Dy390/Documentacion/README.md

# Documntacion del Proyecto 🛠️

_📋 El proyecto consta de distinta informacion documentada en diferentes archivos y formatos._

## Despliegue de informacion 📦

* [🖇️ Circuitos](https://github.com/Dy390/Documentacion/tree/master/Circuitos) - Circuitos esquematicos del proyecto.
* [📄 Especificaciones Tecnicas](https://github.com/Dy390/Documentacion/tree/master/Especif_Tecnicas) - ET del proyecto.
* [📖 Manuales](https://github.com/Dy390/Documentacion/tree/master/Manual) - Manual General, Manual Tecnico, etc.
* [📌 Notas](https://github.com/Dy390/Documentacion/tree/master/Notas) - Notas relacionadas al proyecto.
* [🔧 Herramientas](https://github.com/Dy390/Documentacion/tree/master/Herramientas) - Herramientas del proyecto
* [📄 Protocolos](https://github.com/Dy390/Documentacion/tree/master/Protocolos) - Protocolos

## Autores ✒️

_Quienes desarrollamos aportamos y ayudamos a levantar el proyecto desde sus inicios_

* **Diego Andrés Riquelme** 

## Licencia 📄

Este proyecto está bajo la Licencia 

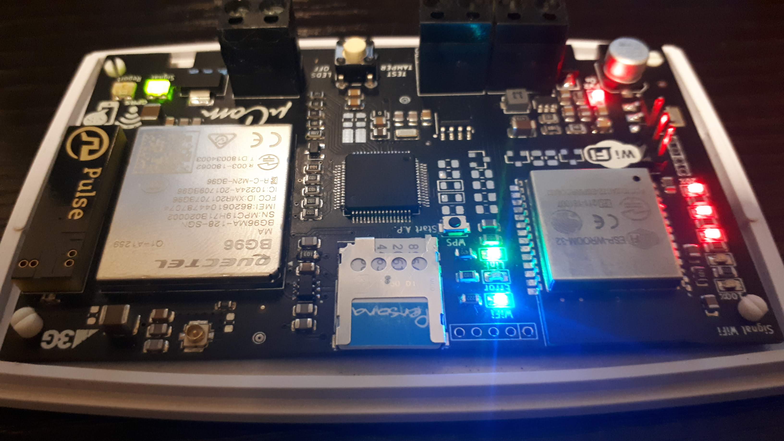
[picture p1: 20200423_143925.jpg]

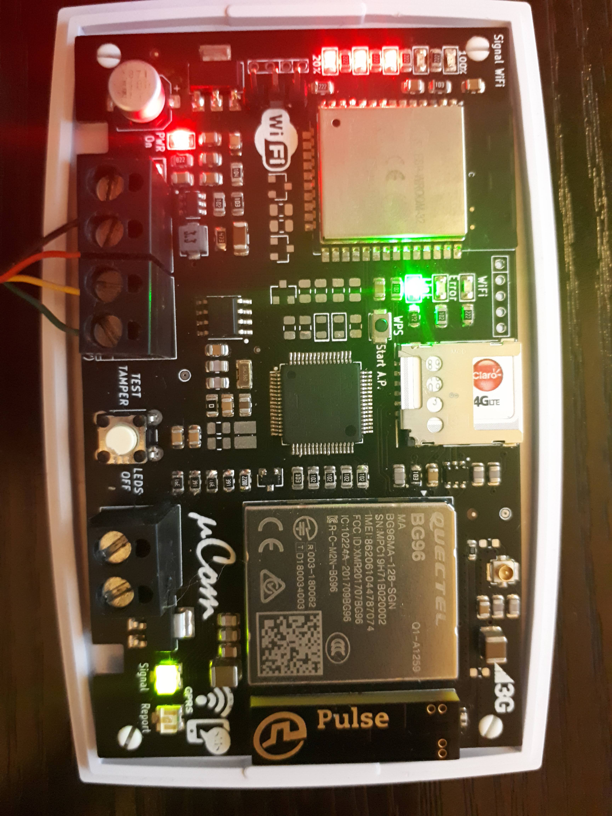
[picture p2: 20200424_222755.jpg]
