Dy390/Documentacion/Especif_Tecnicas/ET_070419_uCOM IP-WIFI_GSM-EGPRS-4G_LTE.pdf

Especificación Técnica: ET-070419 µCom: Comunicador por Bus de Datos

SIIA 04/2019
Rev.: A
1

## ESTADOS DE LED’s DISPOSITIVO

## 1. LED’s DE NIVEL DE SEÑAL WIFI

El equipo “µCom ” indica el nivel dispuestos en placa de la siguiente manera:

LED1 = 20% o menos de señal WiFi recibida).

LED2 = 40% o menos de señal Wi
poderse mejorar).

LED3 = 60% o menos de señal WiFi obtenida (es aceptable y no debería tener inconvenientes)

LED4 = 80% o menos de señal WiFi obtenida (muy aceptable).

LED5 = 100% o menos de señal WiFi obtenida (ideal).

## 2. LED WIFI – WPS - AP (Acces Point)

La indicación de este LED hace referencia al modo en el que trabaja el modulo de comunicación inalámbrica, indicando esto de la sigu

LED WiFi/WPS/AP (Azul)

Encendido fijo = | Indica modo AP
Destellando lento = | Indica WiFi encendido y
Destellando rápido = Indica en modo WiFi e

## 3. LED ERROR / NO-NET

Este LED indica el estado de conexión a la red

LED ERROR / No-Net (Rojo)

Destellando = | buscando conexiones WiFi
Encendido fijo = | No logro conexión con ninguna red WiFi
Apagado = | conectado correctamente a la red WiFi

CONFIDENCIAL

## Y DESCRIPCION DE SWITCHES SIIA µCom) GPRS-GSM/IP-WiFi

de señal WiFi captada en el lugar mediante la indicación

obtenida (se recomienda reubicar dispositivo

Fi obtenida (si se mantiene sin fluctuaciones es aceptable de no

o menos de señal WiFi obtenida (es aceptable y no debería tener inconvenientes)

hace referencia al modo en el que trabaja el modulo de comunicación iente manera:

encendido y WiFi apagado.
AP apagado.
l WPS (aprendiendo red)

conexión a la red WIFI de la siguiente manera:

No logro conexión con ninguna red WiFi conectado correctamente a la red WiFi

## WiFi

de 5 LED’s

para mejorar la señal

2

## 4. LED LINK DE RED WIFI

La indicación de este LED Link, hace referencia a la conexión IP/Dinamic DNS, perteneciente al servidor de recepción de los paquetes de datos por parte del centro de monitoreo.

LED LINK (Amarillo)

Encendido fijo = | Enlazado correctamente
Apagado = | No hay enlace con el Servidor de monitoreo (se recomienda revisar parámetros)
Un destello corto = | El led Link realiza un parpadeo corto cada vez que recibe un ACK d
principal.
Dos destellos cortos = El led Link realiza dos
2 o secundario.
Destellando = | Reservado (aplicación futura)

## 5. LED’S DE LA RED GSM/GPRS

La conexión GSM/GPRS/LTE-M está indicada con dos L
pertinentes al funcionamiento del modulo de comunicación celular vía la red GSM/GPRS por tecnología 2G/3G Y LTE-M por tecnología 4G
Las indicaciones de estos LED’s son las siguientes:

LED DUALES BICOLOR (Verde/Rojo)

EN LA ECUENCIA DE ARRANQUE

LED1 = Enciende por 7 seg
Se mantiene encendido verde fijo al iniciar el modulo GSM en estado OK. LED2 = Rojo fijo indica inicio/reinicio del modulo GSM. Rojo intermitente

SECUENCIA MODULO INICIADO NORMAL

LED1 = Fijo en verde indicando funcionamiento OK del modulo Destellos (de 1 a 5) rojo sobre verde fijo cada 10 seg
LED2 = Fijo en verde indica estado de
Tres pulsos Rojo rápido
Pulsos en color Ámbar después de los pulsos de transmisión de paquetes respuesta ACK a los paquetes

SECUENCIA MODULO CON PROBLEMA

LED1 = | Destellos rápidos
LED2 = | Pulsos Rojo sobre apagado indica Modulo intentando iniciar/buscando

Link, hace referencia a la conexión IP/Dinamic DNS, perteneciente al servidor

vía WiFi a IP/DNS del servidor de monitore No hay enlace con el Servidor de monitoreo (se recomienda revisar parámetros) El led Link realiza un parpadeo corto cada vez que recibe un ACK d

parpadeos cortos cada vez que recibe un ACK d

Reservado (aplicación futura)

## /LTE-M

está indicada con dos LED’s bicolor en placa para realizar las

’s son las siguientes:

. con destellos rápidos rojo en proceso de inicio del modulo e mantiene encendido verde fijo al iniciar el modulo GSM en estado OK.

rápido indica búsqueda de SIM/SIM no detectada.

Fijo en verde indicando funcionamiento OK del modulo
Destellos (de 1 a 5) rojo sobre verde fijo cada 10 seg. indicando nivel de señal. conexión general del Modulo en la red OK rápido indican trasmisión de paquetes de datos en color Ámbar después de los pulsos de transmisión de paquetes a los paquetes recibidos por el servidor.

en rojo sobre apagado indicando Modulo no alimentado Pulsos Rojo sobre apagado indica Modulo intentando iniciar/buscando

o

el Servidor 1 o

el Servidor

indicaciones

indican

SIM, etc.

3

## 6. TOUCH SWITCHES EN PLACA

En la placa del µCom IP-WiFi / GSM
modos del equipo, los mismos están indicados y responden a las siguientes operaciones:

MICRO TOUCH SWITCH MODO WIFI/

Este pulsador obedece al ser presionado por 3 segundos,
para operar la programación
utilización de la aplicación par

TOUCH SWITCH MODO WPS

Al pulsarlo por menos de 3 segundos de los datos de la red WiFi del lugar SSID y PASSWORD de la red WiFi.

TAMPER SWITCH MODO DE PLACA

Este switch tiene prevista la acción principal de reporta ante su apertura la señal correspondiente al evento de anti-desarme y su restauración al cerrarse debidamente el equipo. Pero además cumple la función de poder reportar eventos de
segundo para hacer envíos de prueba al centro de monitoreo. Con la llegada de este reporte, enviara el nivel de señal WiFi que posee el equipo entre otros datos del sistema.
Por último este mismo switch es el enc
cuando el dispositivo es cerrado definitivamente al finalizar la instalación y su ubicación correcta, esto tiene el objeto de bajar el consumo del equipo al máximo evitando
LED’s que ya fueron chequeadas y no son necesarias luego de finalizado el trabajo de instalación.

-GPRS existen tres Touch switches para operación de distintos

AP/WPS

al cambio de modo W
de parámetros del equipo de de forma sencilla y rápid a sistemas operativos Android.

realiza la acción de ingreso a WPS para
, sin tener la necesidad de configurar manualmente

desarme y su restauración al cerrarse debidamente el equipo. Pero además cumple supervisión presionando el mismo por menos de un

i que posee el equipo entre otros datos del sistema. argado de desactivar todos los LED’s

encender
fueron chequeadas y no son necesarias luego de finalizado el trabajo de instalación.

iFi a conexión AP
a mediante la

la autoconfiguración
manualmente los datos de

nando el mismo por menos de un

’s que no son necesarios

encender indicaciones en
