Dy390/Documentacion/Especif_Tecnicas/ET_140220_uCOM_ConectoresPCB.pdf

Especificación Técnica: ET-140220
µCom: Conectores de PCB (Programación – Configuración

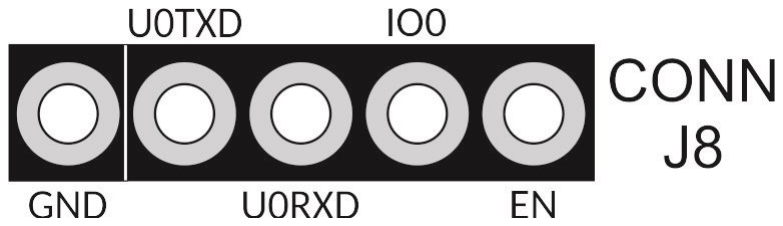
[picture p5: figure]
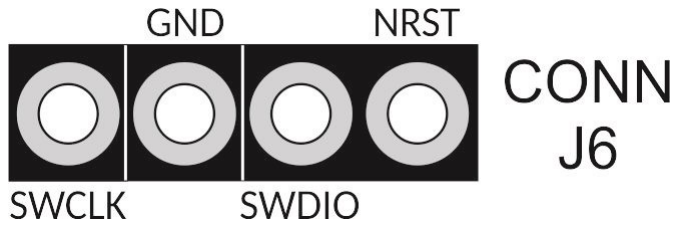
[picture p6: figure]

SIIA 02/2020
Rev.: A
1

# CONECTORES DEL PCB

### 1. CONECTOR DE PROGRAMACION ESP

El conector de programación del ESP-WROOM Los pines utilizados son los siguientes:

1 . GND | => NEGRO
2 . TXD (USART0) | => VERDE
3 . RXD (USART0) | => AZUL
4 . IO0 | => BLANCO
5 . EN | => ROJO

### 2. CONECTOR DE PROGRAMACION SWD

El conector de programación del microcontrolador ST32G070RB es un conector de 4 pines vertical del tipo 1x04 paso = 2mm
Se utiliza SWD del ST-Link-V2 (Discovery
Los pines utilizados son los siguientes:
1 . SWCLK (CLOCK) | => AMARILLO
2 . GND | => NEGRO
3 . SWDIO (DATA) | => VERDE
4 . NRST (RESET) | => NARANJA

### 3. CONCTOR DE CONFIGURACION Y DEBUG SERIAL

El conector de programación de programación
Se utiliza en configuración estándar serial RS232 TX
Los pines utilizados son los siguientes:
1 . GND | => NEGRO
2 . TX (Trans. Data) | => AMARILLO
3 . RX (Res. Data) | => VERDE

Configuración – Debug)

CONFIDENCIAL

# CONECTORES DEL PCB µCom

### -WROOM-32

WROOM-32 es un conector del tipo de 5 pines verticales del tipo

### SWD DEL STM32G070RB

-Nucleo64-clon chino USB)

serial es un conector de 3 pines vertical del tipo -RX

1x05 paso = 2mm

1x03 paso = 2.54mm
