Dy390/Documentacion/Especif_Tecnicas/ET_Terminologia_Comandos_SMS.pdf

Especificación Técnica: ET-060419 µCom: Terminología de comandos de p

SIIA 04/2019
Rev.: | A
Pag. | 1

La programación se realiza por completo en forma remota por la App bien por SMS.

Introducción a la programación por

El procedimiento de programación por SMS de un comunicador
diseñado para que sea sencillo e intuitivo, de manera que sea posible programarlo desde cualquier teléfono celular. Simplemente
es necesario seguir una serie de reglas sencillas y conocer los comandos para la configuración de los diferentes parámetros del equipo.
guardada como plantilla en el teléfono celular, en caso que se quiera utilizar alguna función especial del equipo podría ser necesario consultar el manual.

Para la programación del equipo e
comunicador, también llamad

La clave de programación o P

La programación se puede realizar desde cualquier teléfono celular vía SMS.

Se puede programar el comunicador enviando SMS
al número de la SIM del comunicador, los mensajes deben comenzar con el siguiente encabezado y continuar con los distintos comandos o parámetros separados entre comas.

Encabezado: MCLTE*1234,

Donde MCLTE es el encabezado que
la PROGKEY del comunicador.

Los SMS no deben superar los 140 caracteres, en caso de mayor longitud, de enviar varios SMS, pero todos con el mismo encabezado. No se exige ningún orden en los comandos.
Los comandos y parámetros con contenido numérico deben tener la cantidad de dígitos especificada completando con ceros a la izquierda cuando sea necesario. Lo dicho no aplica para APNs, users, passwords, IPs, PORTs, y SMS.

Ejemplo de SMS a enviar desde cualquier teléfono celular o modem SMS al SIM
del comunicador:

MCLTE*1234,PROGKEY=4321,

Este comando de programación indica al comunicador, cuyo código de instalador es 1234, que cambie la PROGKEY a 4321
Como respuesta a cualquier comando o programación por SMS, el comunicador responderá con los SMS necesarios con toda su programación al celular o módem de
el SMS, lo que permite asegurase que la programación fue recibida y verificar si impactó en el comunicador como se deseaba.

REPORTES SMS RESIDENCIAL

MicroCom permite el envío de reportes
utilizando el servicio de SMS de la compañía telefónica.
Si el formato “SMS Residencial
el usuario podrá recibir reportes de eventos en sus teléfonos. Los eventos importantes transmitidos
Alarmas, Armado/Desarmado, Fallos de alimentación, entre otros.

419
rogramación SMS

## PROGRAMACIÓN SMS

Config del instalador o

SMS

MicroCom
para que sea sencillo e intuitivo, de manera que sea posible programarlo desde cualquier

En general la configuración básica es muy simple y se puede tener

s necesario conocer la clave de programación
a programming key en adelante PROGKEY

ROGKEY de fábrica es 1234.

’s desde un teléfono celular o modem

siempre debe estar presente al comienzo del mensaje y

smo encabezado. No se exige ningún orden en los comandos.

ords, IPs, PORTs, y SMS.

con toda su programación al celular o módem desde donde recibió

AUTOMATICOS

automáticos a los teléfonos celulares configurados

” está habilitado en la programación del equipo MicroCom,

serán:

del instalador o

-WiFi/4GLTE está

del

1234 es

donde recibió

nfigurados

Pag. 2

COMANDOS REMOTOS DEL USUARIO

Otra facilidad de MicroCom es la de poder enviar remotamente comandos al sistema de alarma en forma de mensaje SMS si esta se encuentra habilitada en la
Si por razones de seguridad quiere limitar el uso de comandos remotos SMS, solamente a teléfonos de conocimiento del usuario, entonces estos deben estar previamente configurados en MicroCom para ser contrastados con los teléfonos
contrario MicroCom responderá al mismo teléfono que envió el mensaje SMS, siempre y cuando respete el formato de comunicación obligatorio.

Formatos de Comandos: [s][clave][
Donde:
[s] = | es un espacio, un punto, un asterisco (*) o un numeral (#)
[clave] = | es la clave de usuario de partición
[s] = | es un espacio
[comando] = | es el comando a ejecutar según tabla
[s] = | es un espacio solo si hay nº zona como parámetro Ej. (z01)
[parámetro] = Numero de Zona de uno o dos caracteres
| Salida [OUT]

* Comandos en letra minúscula

Ej. para ejecutar la acción SMS de Armar y Desarmar
ARMAR: | [ 1234 armar]
DESARARMAR: [ 1234 desarmar
* (Tener en cuenta el espacio inicial)
** (1234 = clave del usuario para la Partición

Ej. para ejecutar la acción SMS de Anular y Restaurar zona 5 enviar:
ANULAR ZONA: | [ 1234 anular z05
RESTAURAR ZONA: | [ 1234 restaurar z05
* (Tener en cuenta el espacio inicial)
** (1234 = clave del usuario para la Partición
Ej. para ejecutar la activar la Salida [OUT] del equipo
ACTIVAR SALIDA: | [ activar salida
DESACTIVAR SALIDA: | [ desactivar salida
* (Tener en cuenta el espacio inicial)
** (este comando no necesita clave del usuario

El equipo responderá a estos comandos

SISTEMA ARMADO
SISTEMA DESARMADO
ZONA 05 ANULADA
ZONA 05 RESTAURADA

:

programación de MicroCom.

que envían el mensaje SMS

s][comando][s][parámetro]

espacio, un punto, un asterisco (*) o un numeral (#)

e idioma.
es un espacio solo si hay nº zona como parámetro Ej. (z01)
Numero de Zona de uno o dos caracteres precedidos de espacio, o
| ESPAÑOL * | PORTUGUEZ * | INGLES *
ARMAR SISTEMA (CERRAR) | armar | armar | arm
DESARMAR SISTEMA (ABRIR) | desarmar | desarmar | disarm
ANULAR ZONA | anular | cancelar | bypass
DESANULAR ZONA | restaurar | restaurar | restore
ACTIVAR SALIDA | activar salida | ativar saída | output on
DESACTIVAR SALIDA | desactivar salida | desativar saída | output off
ACTIVAR SIRENA | activar sirena | ativar sirene | bell on
DESACTIVAR SIRENA | desactivar sirena | desativar sirene | bell off
CONSULTA ESTADO | estado | estado | status

de Armar y Desarmar enviar:

]

)

1234 anular z05 (puede enviarse 05, o también 5)] 1234 restaurar z05 (puede enviarse 05, o también 5)]

)
alida [OUT] del equipo:
]
desactivar salida]

)

con los siguientes textos indicando el estado del panel

. De lo

Activar

Pag. 3
