Dy390/Documentacion/Especif_Tecnicas/ET_290319_uCOM_FORMATO DE COMUNICACION DE PAQUETES.pdf

Especificación Técnica: ET-290319 µCom: Comunicador por Bus de Datos

SIIA 03/2019
Rev.: A
1

CONFIDENCIAL

## ESPECIFICACION DEL FORMATO DE MENSAJES USADOS EN EL DISPOSITIVO IP-WiFi/

## 1. Conceptos Iniciales

En este documento se detalla el reporte de eventos hacia la equipo usando el protocolo de comunicación ContactID Llamaremos “µCom ” (micro_communicator) interconexión a un Panel de alarmas en forma directa
Cada mensaje enviado por el dispositivo
proveniente desde el sistema receptor en la
Si el µCom no recibe un ACK dentro de un tiempo establecido, luego de realizar todas las programadas, entonces reintentará el envío por SMS
está habilitado para usar estos servicio

## 2. Comandos, Reportes y Seguridad

Definiremos como “Comando” a aquellos mensajes de datos enviados al
remoto con fines de consulta, configuración, o control remoto. Todo comando espera dispositivo.
Los Comandos no se detallan en este documento
De la misma forma, definiremos como “Reporte” a los mensajes enviados por el destinatario, conteniendo reportes de alarmas, problemas, test, etc. El
sean “reconocidos” (o respondidos) por su receptor.
En el caso que se envíe un mensaje por SMS
dos caracteres ASCII, representando el valor hexadecimal del byte. De esta manera se garanti
los caracteres sean aceptados por los diferentes “data schemes”. Al final, la estructura del mensaje será similar a la usada para GPRS.
En SMS se espera que el mensaje de respuesta o ACK, se reciba por el mismo medio.
Cuando se transmita por GPRS, se usará UDP para comunicar con la C
En ambos casos el mensaje del evento puede estar encriptado o no, dependiendo de la configuración del µCom.
En el caso que se encripte el mensaje, la totalidad del mismo será

## 3. Reportes con Protocolo

Este protocolo debe parecerse al implementado por otros fabricantes de productos IP. El protocolo se transmite tanto por GPRS / IP como por SMS sin encriptación.
Para la detección de errores, se utiliza
Se transmite siempre, usando UDP.
A continuación, un ejemplo de los reportes que se generan en el dispositivo envían en el reporte son con estructura Contact ID.
Los diferentes campos de la información e

# SIIA microCom (µCom)

## GSM-UMTS-LTE-M (2G-3G-4G)

detalla el reporte de eventos hacia la Centro Monitoreo de comunicación ContactID.
al Comunicador GPRS- GSM/IP
a través de su bus de datos. µCom, deberá ser validado por una respuesta de aceptación o ACK CMA.
no recibe un ACK dentro de un tiempo establecido, luego de realizar todas las (a la CMA) y/o vía Email o WhatsApp s.

µCom

en este documento (ver ET. Comandos).

µCom espera que todos los Repor

(a la CMA), cada byte será codificado para su transmisión, como

GPRS, se usará UDP para comunicar con la CMA.

encriptado.

## Contact ID

al implementado por otros fabricantes de productos IP.

el cksum del Contact ID.

stán separados por comas (,).

)

Alarmas (CMA) desde el

IP-WiFi, diseñado para su

repeticiones
(al Usuario) solo si

desde un sistema receptor
rá una respuesta del

µCom hacia su receptor o
espera que todos los Reportes

za que todos

µCom. Los eventos que se

2

### $D,acct,seq,timestamp,CIDdata,RSSI,frec,vers,id,$C

Donde:

$D | Es un header de 2 caracteres: ASCII 36 (hex. 24) seguido del ASCII 68 (hex. 44).
acct | Este campo es para identificar al dispositivo IP. Son siempre los 4 dígitos del Número de
Cuenta correspondiente al
seq | A cada mensaje se le aplica un número de secuencia o número de mensaje. El sistema de
recepción responderá con un mensaje de ACK con el mismo número de mensaje al cual se está reconociendo. El rango es de 01 a 99 y son siempre 2 cifras.
DateTime Indica en qué fecha y hora
formato es: DD/MM/YYYY
CIDdata La totalidad de los datos son caracteres ASCII y corresponden a una estructura de Contact ID con 16 cifras.
RSSI | Son dos caracteres indicando el nivel de señal recibida. Los valores transmitidos son los
que muestra el modulo
señal). Solo válido para dispositivos GPRS.
frec | Este campo especifi
Vers | Este campo especifica el número de versión del hardware y del Firmware
caracteres.
Id | Son 7 dígitos correspondientes al ESN que coincide con el final del IMEI en disposit
GPRS.
$C | Este es el finalizador

Ejemplo:
$D,8888,01,01/01/2000-00:0
4. Reporte Periódico de Supervisión (Prot.

Cuando se opera en GPRS, se puede generar un reporte periódico de supervisión, que solo se envíe por este medio. Es decir, si no se recibe ACK de este mensaje no se enviará por SMS.
La estructura del mensaje de supervisión es la misma que en el ejemplo an
denominado CIDdata se llena con 16 ceros.
Así, el ejemplo anterior queda:
$D,8888,01,01/01/2000-00:00
$D | Comienzo del paquete de datos
8888 ID del dispositivo (

### 01 Numero de paquete (01 a 99)

01/01/2000 | Fecha DD/MM/AAAA
00:00 | Hora y Minutos
0000000000000000 | Protocolo Contad

### 18 Nivel de señal

2 Supervisa cada 2 minutos.
5_6.7 | 5 Es la versión de hardware de placa y 6.7 versión de firmware

Es un header de 2 caracteres: ASCII 36 (hex. 24) seguido del ASCII 68 (hex. 44).
Este campo es para identificar al dispositivo IP. Son siempre los 4 dígitos del Número de µCom (ID del panel de alarma). A cada mensaje se le aplica un número de secuencia o número de mensaje. El sistema de recepción responderá con un mensaje de ACK con el mismo número de mensaje al cual se está reconociendo. El rango es de 01 a 99 y son siempre 2 cifras.
fecha y hora el mensaje fue encolado para su transmisión a la -HH:MM y son siempre 16 cifras.
La totalidad de los datos son caracteres ASCII y corresponden a una estructura de Contact

Son dos caracteres indicando el nivel de señal recibida. Los valores transmitidos son los de GPRS con el comando AT+CSQ y van de 00 a 32 (32 = 100% de

ca la frecuencia de los reportes de supervisión de GPRS en minutos. Este campo especifica el número de versión del hardware y del Firmware

Son 7 dígitos correspondientes al ESN que coincide con el final del IMEI en disposit

dor del paquete. Son dos caracteres.

0, 0501183145010001,18,2,1_1.1,12

## CID)

,0000000000000000, 18,2,1_1.1,1234567,$C

Comienzo del paquete de datos Número de cuenta )
Numero de paquete (01 a 99)

-ID Si es todo 0 es un evento de supervisión
(es un número de 0 a 32 donde 32 es el 100 % de señal GSM

### 5 Es la versión de hardware de placa y 6.7 versión de firmware

CMA El

. Son cinco

ivos

34567,$C

terior, pero el campo

)

3

1234567 IMEI (últimas 7 cifras)
$C | Finalizador del

## 5. Acknowledges (Prot. CID

Cuando la CMA, recibe un evento desde el Ejemplo de respuesta de ACK:

### $D,8888,TI=01/01/2000-00:0

Esta es una respuesta de ACK para el ejemplo anterior, donde:
$D | Comienzo del paquete de datos
8888 ID del dispositivo
01/01/2012 | Fecha DD/MM/AAAA
00 :07:00 | Hora, Minutos y Segundos
ACK=01 | Número de paquete (01 a 99) que se
$C | Finalizador del paquete

paquete.

)

µCom, debe responder con un mensaje de reconocimiento.

### 0:00,ACK=01,$C

(Número de cuenta)

está reconociendo
paquete
