Dy390/Documentacion/Protocolos/POSITRON/PROTOCOLO DE COMUNICACIÓN DE LA RED HOME.pdf

## Protocolo de comunicación de la red HOME

## INTRODUCCION

Este documento describe el protocolo de comunicación de la red HOME, que se utiliza para establecer una red de comunicación para productos de la línea doméstica (estaciones de alarmas centrales, teclados, etc.).

## MENSAGE FORMATO GENERAL

El formato general del mensaje se presenta en la Figura 1. Esta figura muestra todos los campos del mensaje, incluso los opcionales. El significado de los campos se presenta en la tabla 1 y se explica con más detalle en los siguientes temas.

Figura 1 - Formato general del mensaje de protocolo HOME

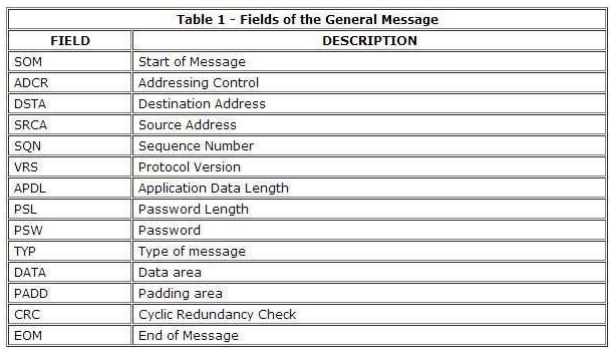
[picture p33: figure]

Table 1 - Fields of the General Message

## PROTOCOLO DE COMUNICACIÓN DE LA RED HOME -CAPA FÍSICA

La capa física utilizada en el protocolo HOME es RS485. Baud Rate: 57600 8bits / 1 stop bit No parity

## PROTOCOLO DE COMUNICACIÓN DE LA RED HOME – CAPA DE ENLACE DE DATOS

La capa de enlace de datos es responsable de generar o procesar el mecanismo de validación de mensajes (para la detección o recuperación de errores) y para la encapsulación de cuadros. Por lo tanto, esta capa agrega o procesa los campos de validación y encapsulación del mensaje, como se muestra en la figura 2.

CRC

Figure 2 - Parte del mensaje en la capa de enlace de datos

El CRC utilizado en este protocolo es una versión de 16 bits del CCITT, con el siguiente polinomio:

Marcando caracteres

Figura 3 - CRC polinomio

Los caracteres de marcado son caracteres especiales que se utilizan para marcar el inicio y el final del mensaje. Además, como estos caracteres pueden aparecer normalmente dentro del mensaje básico, existe un mecanismo para detectar y evitar este problema. Este mecanismo es la secuencia de escape y utiliza un carácter especial, el carácter de escape y un operador de escape, para evitar la incidencia de caracteres de marcado dentro del mensaje.

Los caracteres marcados y el operador de escape son:

- Inicio del mensaje (SOM): 0x28
- Fin del mensaje (EOM): 0x29
- Personaje de escape (ECH): 0x27
- Operador de escape (EOP): 0x40

El mecanismo de escape funciona de la siguiente manera: si, dentro del mensaje básico, hay un carácter equivalente a un carácter de marca, se inserta un carácter de escape (ECH) antes de que este carácter sufra una operación XOR con el operador de escape (EOP). ).

En la transmisión, los caracteres de marcado se agregan al mensaje después de que se compone el mensaje básico. En la recepción, los caracteres de marcado deben excluirse del mensaje antes de interpretar el mensaje básico.

## PROTOCOLO DE COMUNICACIÓN DE LA RED HOME -CAPA DE RED

La capa de red es responsable de controlar el mecanismo de direccionamiento del protocolo. Esta capa agrega o procesa los campos de dirección del mensaje, como se muestra en la figura 4.

Figura 4 - Parte del mensaje en la capa de red
ADCR - Control de direccionamiento

Este es un campo de bits con 1 byte de longitud, utilizado para controlar el mecanismo de direccionamiento del protocolo. La función de cada bit se muestra en la tabla 2 a continuación:

Tabla 2 - Control de direccionamiento
DSTA - Dirección de destino

Este es un campo opcional y contiene la dirección de destino (dirección del dispositivo que debe recibir el mensaje). Este campo no existe en los mensajes de difusión (mensajes dirigidos a todos los dispositivos en el bus).

SRCA - Dirección de origen

Este es un campo opcional y contiene la dirección de origen (dirección del dispositivo que generó el mensaje). Para mensajes que no necesitan respuesta, este campo no existe.

SQN - Número de secuencia

El número de secuencia es un campo de 1 byte y se utiliza para identificar los mensajes originales y sus respuestas. El mensaje de respuesta debe contener el mismo número de secuencia del mensaje que lo originó.

Para los mensajes que necesitan respuesta, el dispositivo de origen debe esperar la respuesta por un tiempo de espera determinado. Si este tiempo de espera expira y la respuesta no se recibe, la fuente debe reenviar el mensaje con el mismo número de secuencia. Además, el dispositivo de origen debe intentar enviar el mensaje una cantidad determinada de veces (este parámetro se conoce como número de reintentos). Después de que este número expire, la fuente debe darse por vencida.

Direcciones

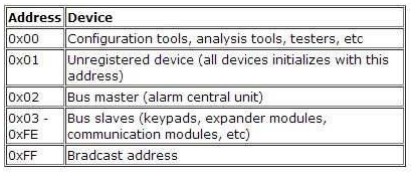
[picture p34: figure]

Tabla 3 – Direcciones

## PROTOCOLO DE COMUNICACIÓN DE LA RED HOME -CAPA DE PRESENTACIÓN

La capa de presentación es responsable de controlar el cifrado de la parte de la aplicación del mensaje (datos de la aplicación) y controlar la versión del protocolo. Esta capa agrega o procesa los campos de versión y de relleno del mensaje, como se muestra en la figura 5.

Figure 5 - Parte del mensaje en la capa de presentación

VRS - Versión

Este es un campo de bits con 1 byte de longitud. Los 4 bits menos significativos (bits 3 a 0) definen la versión del protocolo (la versión actual es 0). El bit más significativo (bit 7) define si el cifrado se aplica a los datos de la aplicación (si el valor del bit es 1, se aplica el cifrado). Los otros bits (6,5,4) no se utilizan ahora y son gratuitos para futuras necesidades (en este momento, se recomienda rellenarlos con 0).

APDL - Longitud de datos de aplicación

Este es un campo de 1 byte que contiene la longitud de los datos de la capa de aplicación. La capa de presentación necesita esta información para separar los datos de aplicación de los datos de relleno.

PADD - Área de relleno

Este campo contiene el área de relleno del mensaje, que es necesaria para algunos tipos de cifrado que restringen que los datos cifrados sean un múltiplo de cierta longitud (por ejemplo, un múltiplo de 4 bytes). Por lo tanto, si el cifrado tiene esta restricción y la longitud del mensaje no es un múltiplo de la longitud requerida, el mensaje debe completarse con bytes de relleno para alcanzar la longitud necesaria. Por ejemplo, si un mensaje tiene 13 bytes y necesita ser un múltiplo de 4 bytes, debe completarse con 3 bytes de relleno, para alcanzar una longitud de 16 bytes. El valor de los bytes de relleno debe elegirse de manera aleatoria y, preferiblemente, no debe ser igual. Si el mensaje no está cifrado, el área de relleno no es necesaria y no se incluye en el mensaje.

Cifrado

Si el cifrado está habilitado, se aplica a los datos de la aplicación y al área de relleno. En este momento, no se utiliza ningún cifrado (el bit 7 de VRS es 0).

## PROTOCOLO DE COMUNICACIÓN DE LA RED HOME -CAPA DE APLICACIÓN

La capa de aplicación es responsable de procesar o ensamblar la parte de datos del mensaje. Esta porción de datos está compuesta por los campos presentados en la figura 6.

Figura 6 - Parte del mensaje en la capa de aplicación

PSL - Longitud de la contraseña

Este campo informa la longitud de la contraseña, que es el siguiente campo del mensaje. Si no hay contraseña, PSL es cero.

PSW - Contraseña

Este es un campo opcional y contiene la contraseña del usuario que está accediendo al sistema. Hay algunos mensajes que no necesitan contraseña; en estos casos este campo no existe (PSL = 0). Consulte el Diccionario de datos para obtener una explicación del formato de las contraseñas.

Tipos de mensajes

El tipo de campo de mensaje se utiliza para identificar los mensajes. La siguiente tabla presenta el tipo de mensajes para el protocolo HOME y el significado del área de datos.

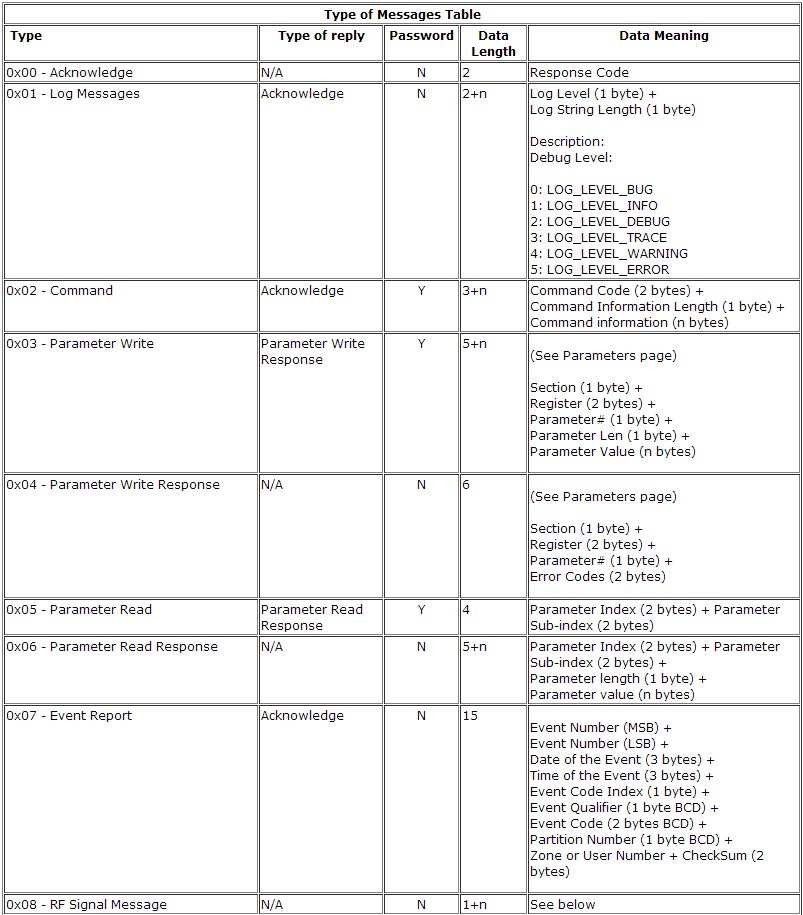
[picture p35: figure]

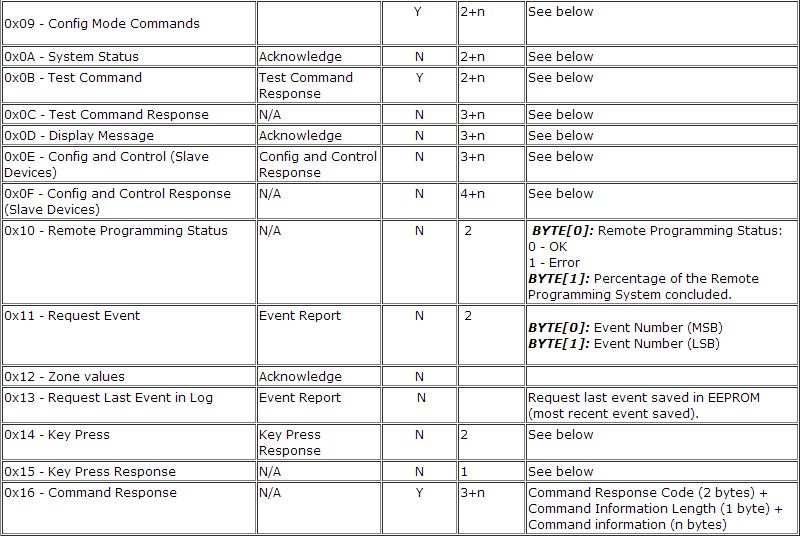
[picture p36: figure]

Tabla 4 – Tipo de Mensaje

Obs: solo las contraseñas de instalador y maestro (maestro de sistema y maestro de particiones) deben aceptarse en los mensajes que necesitan contraseña. Los mensajes que vienen con las contraseñas de los usuarios normales deben ser rechazados.

Formato de los datos

Ver Protocolo de comunicación de red HOME - Diccionario de datos para una explicación de los varios tipos de datos utilizados en el protocolo y en los dispositivos.

Códigos de respuesta

Los códigos de respuesta se utilizan en el mensaje de confirmación para informar el resultado de la acción solicitada por el mensaje que originó la confirmación. Por ejemplo, un mensaje de lectura de parámetro con un índice no válido debe responderse con un mensaje de confirmación con un código de respuesta configurado como índice no válido.

Ver Protocolo de comunicación de red HOME - Diccionario de datos para
obtener una lista de los códigos de respuesta utilizados actualmente.

Comandos

Los mensajes de comando se utilizan para enviar comandos a los dispositivos en el bus. Ver Protocolo de comunicación de red HOME - Comandos.

Comandos de Respuesta

Los mensajes de respuesta de comando se utilizan para responder con el estado de ejecución del comando respectivo.
Ver Protocolo de comunicación de red HOME - Comandos de respuesta para obtener una lista de los códigos de respuesta utilizados actualmente.

Parámetros de mensajes

Ver Protocolo de comunicación de red HOME - Parámetros.

Eventos

Ver Protocolo de comunicación de red HOME - Eventos.

Mensaje de estado del sistema

Ver Protocolo de comunicación de red HOME - Estado del sistema

## PROTOCOLO DE COMUNICACIÓN DE LA RED HOME -DICCIONARIO DE DATOS

Esta página presenta la información sobre los formatos de los diversos tipos de datos utilizados en el Protocolo de comunicación de la red HOME y, por consiguiente, en los dispositivos que pertenecen a la línea HOME.

Número de cuenta

Este formato se usa para representar el número de cuenta, o la identificación del suscriptor, que se usa en el protocolo ContactID para identificar la estación principal del CMS.

- Formato: número entero corto sin signo (2 bytes).
- Rango válido: 0 a 0xFFFF.

Métodos de Armado

Este formato se utiliza para representar los métodos de armado, es decir, un campo de bits de 8 bits, como se presenta en la tabla a continuación.

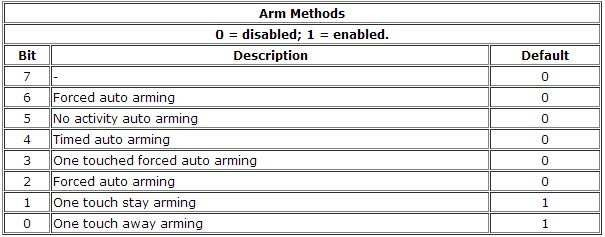
[picture p37: figure]

Tabla 5 – Métodos de Armado

Fecha

Este formato se utiliza para representar fechas. Formato: 3 bytes, ddmmyy (d = día; m = mes; y = año). Rango valido: día: 1 a 31. mes: 1 a 12. año: 1 a 255 (valido 2001 a 2255). 000000 significa que la fecha no es válida.

Número de grupo

Este formato se utiliza para representar un número de grupo. Format: unsigned 1 byte. Valid range: 0 to 99. 0 means no group. 99 is used to indicate all groups.

Numero de Partición

Este formato se utiliza para representar un número de partición. Formato: unsigned 1 byte. Rango válido: 0 a 99. 0 significa que no hay partición. 99 se usa para indicar todas las particiones.

Contraseña

Este formato se utiliza para representar las contraseñas utilizadas en el sistema, como el instalador, las contraseñas maestras y las contraseñas de los usuarios. Las contraseñas tienen 4 o 6 dígitos y se almacenan y envían en formato BCD. Normalmente hay otro campo, Longitud de la contraseña (PSL), que define el tamaño de la contraseña. Así, las contraseñas pueden ser: 4 dígitos decimales (de 0000 a 9999). En este caso, PSL = 2 bytes. 6 dígitos decimales (desde 000000 hasta 999999).

Número de teléfono

Este formato se utiliza para representar números de teléfonos utilizados en el sistema. Este es un número de 16 bytes, y cada byte de este número representa 2 dígitos (cada 4 bits del byte representa un dígito). El primer dígito no decimal marca el final del número. Con 16 bytes, es posible representar un número de hasta

### 32 dígitos (esto permite agregar dígitos especiales a un número de

teléfono si es necesario). Por ejemplo, el número de teléfono 021 19 3787 6200 se representaría como (02 11
93 78 76 20 0F 00 00 00 00 00 00 00 00 00).

Códigos de razón y respuesta

Los códigos de razón y respuesta se usan para enviar información sobre la respuesta o la razón de esa respuesta. Normalmente se utilizan en los mensajes de respuesta. Son un campo de 2 bytes.

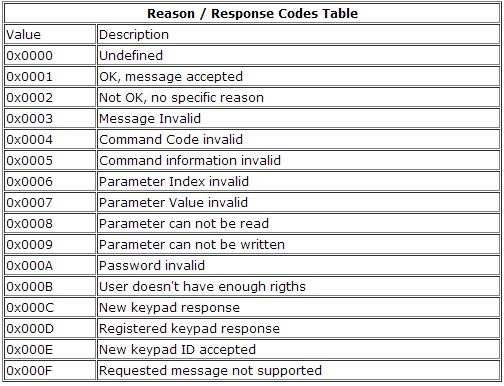
[picture p38: figure]

Tabla 6 - Códigos de razón y respuesta

Time

Este formato se utiliza para representar la hora del día, en general. Formato: 3 bytes, hhmmss (h = hora; m = minutos; s = segundos). Rango Valido: hora: 0 a 23. minutos: 0 a 59. segundos: 0 a 59. 999999 significa que el tiempo no es válido.

Numero Usuario

Este formato se utiliza para representar los números de los usuarios. Formato: entero sin signo corto (2 bytes). Rango Valido: 0 a 999. 0 significa ningún usuario específico. 999 Se utiliza para indicar a todos los usuarios..

Numero Zone

Este formato se utiliza para representar números de zona. Formato: entero sin signo corto (2 bytes). Rango Valido: 0 a 999. 0 significa que no se aplica ninguna zona. 999 se utiliza para indicar todas las zonas.

## PROTOCOLO DE COMUNICACIÓN DE LA RED HOME -COMANDOS

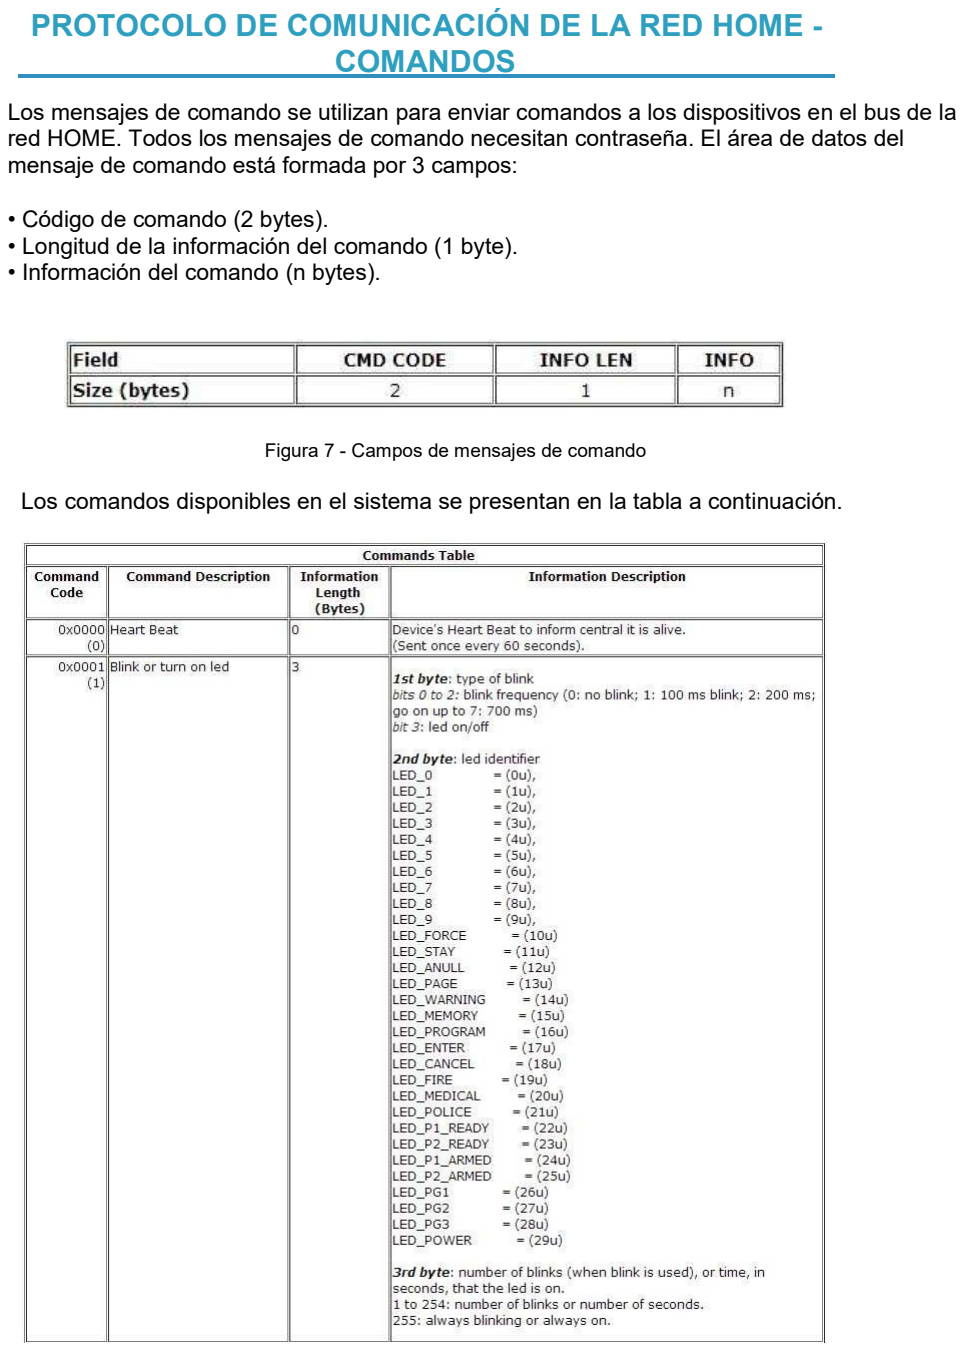
[picture p39: page 14]

Los mensajes de comando se utilizan para enviar comandos a los dispositivos en el bus de la red HOME. Todos los mensajes de comando necesitan contraseña. El área de datos del mensaje de comando está formada por 3 campos:

- Código de comando (2 bytes).
- Longitud de la información del comando (1 byte).
- Información del comando (n bytes).

Figura 7 - Campos de mensajes de comando

Los comandos disponibles en el sistema se presentan en la tabla a continuación.

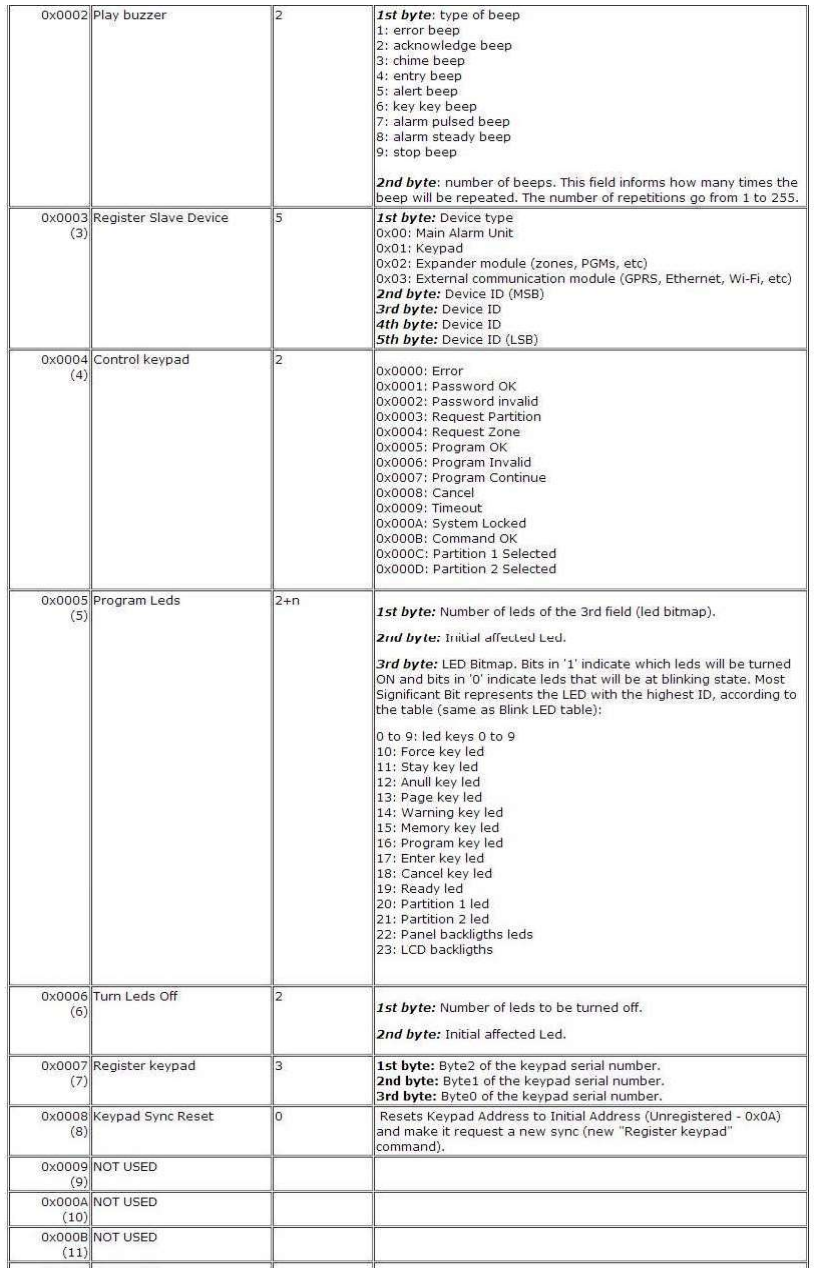
[picture p40: figure]

Tabla 7 – Tabla Comandos

## PROTOCOLO DE COMUNICACIÓN DE LA RED HOME – RESPUESTA DE COMANDOS

Los mensajes de respuesta de comando se usan para enviar el estado del comando a los dispositivos en el bus de la red HOME.
El área de datos del mensaje de comando está formada por 3 campos:
- Código de respuesta del comando (igual que el comando respectivo) (2 bytes).
- Longitud de la información del comando (1 byte).
- Información del comando (n bytes).

Figura 8 - Campos de mensajes de respuesta de comando

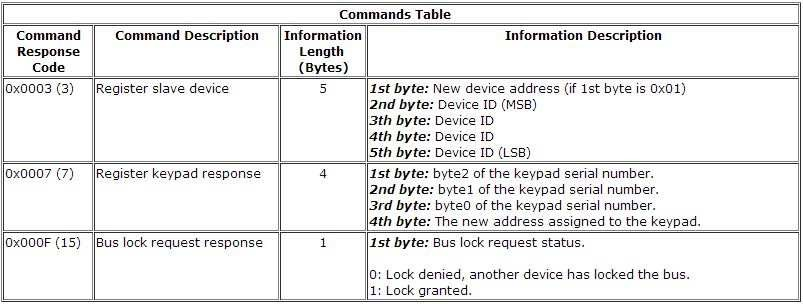
[picture p41: figure]

Tabla 8 - Tabla de respuesta de comandos

## PROTOCOLO DE COMUNICACIÓN DE LA RED HOME – PARAMETROS

Los sistemas de alarma HOME tienen muchos parámetros de configuración que se pueden LEER y / o ESCRIBIR a través de algunos mensajes de protocolo.
A continuación, se encuentran las descripciones de los mensajes de protocolo y todos los parámetros que pueden LEER / ESCRIBIR con estos mensajes.

### 1. MENSAJES DE PARÁMETROS

PARÁMETRO ESCRIBIR SECTION (1 byte de longitud): El número de la sección.. REGISTER (2 byte de longitud): El número del registro.. PARAMETER (1 byte de longitud): El número del parametro. PARAM LEN (1 byte de longitud): La longitud en bytes del parámetro.. PARAM VALUE (n bytes): Contiene el valor del parámetro.

PARÁMETRO ESCRIBIR RESPUESTA SECCIÓN (longitud de 1 byte): El número de la sección. REGISTRO (2 bytes de longitud): El número del registro. PARÁMETRO (longitud de 1 byte): el número del parámetro. CÓDIGOS DE ERROR (longitud de 2 bytes): código de error de escritura de parámetro, según

la tabla 6.

PARAMETRO LEER

- SECCIÓN (longitud de 1 byte): El número de la sección.
- REGISTRO (2 bytes de longitud): El número del registro.
- PARÁMETRO (longitud de 1 byte): el número del parámetro.

PARAMETRO LEER RESPUESTA SECCIÓN (longitud de 1 byte): El número de la sección. REGISTRO (2 bytes de longitud): El número del registro. PARÁMETRO (longitud de 1 byte): el número del parámetro. PARAM LEN (longitud de 1 byte): la longitud en bytes del parámetro. VALOR DE PARAM (n bytes): contiene el valor del parámetro.

### 2. DESCRIPCIÓN DE LOS PARÁMETROS DE CONFIGURACIÓN DEL SISTEMA

SECCIONES: La configuración del sistema se divide en secciones.
Estas secciones y sus respectivos números de sección se enumeran a continuación:

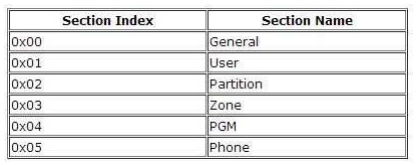
[picture p42: figure]

REGISTROS: Cada sección tiene una serie de registros. Todos los registros de una sección tienen el mismo formato y almacenan una serie de parámetros. La siguiente tabla especifica el número de registros por sección.

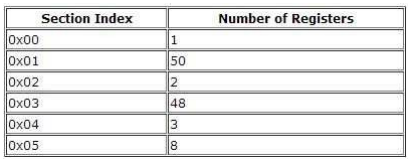
[picture p43: figure]
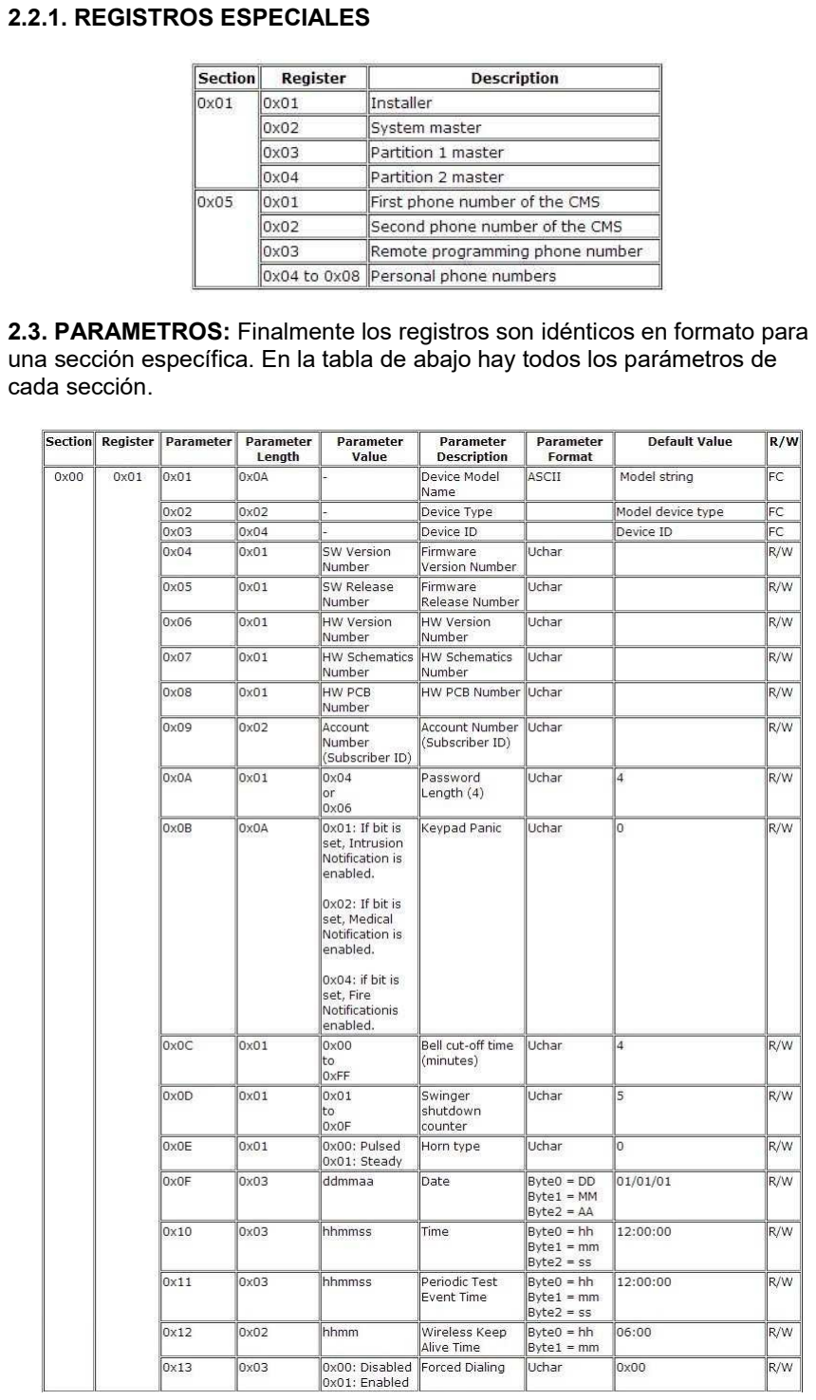
[picture p44: page 19]

### 2.2.1. REGISTROS ESPECIALES

### 2.3. PARAMETROS: Finalmente los registros son idénticos en formato para

una sección específica. En la tabla de abajo hay todos los parámetros de cada sección.

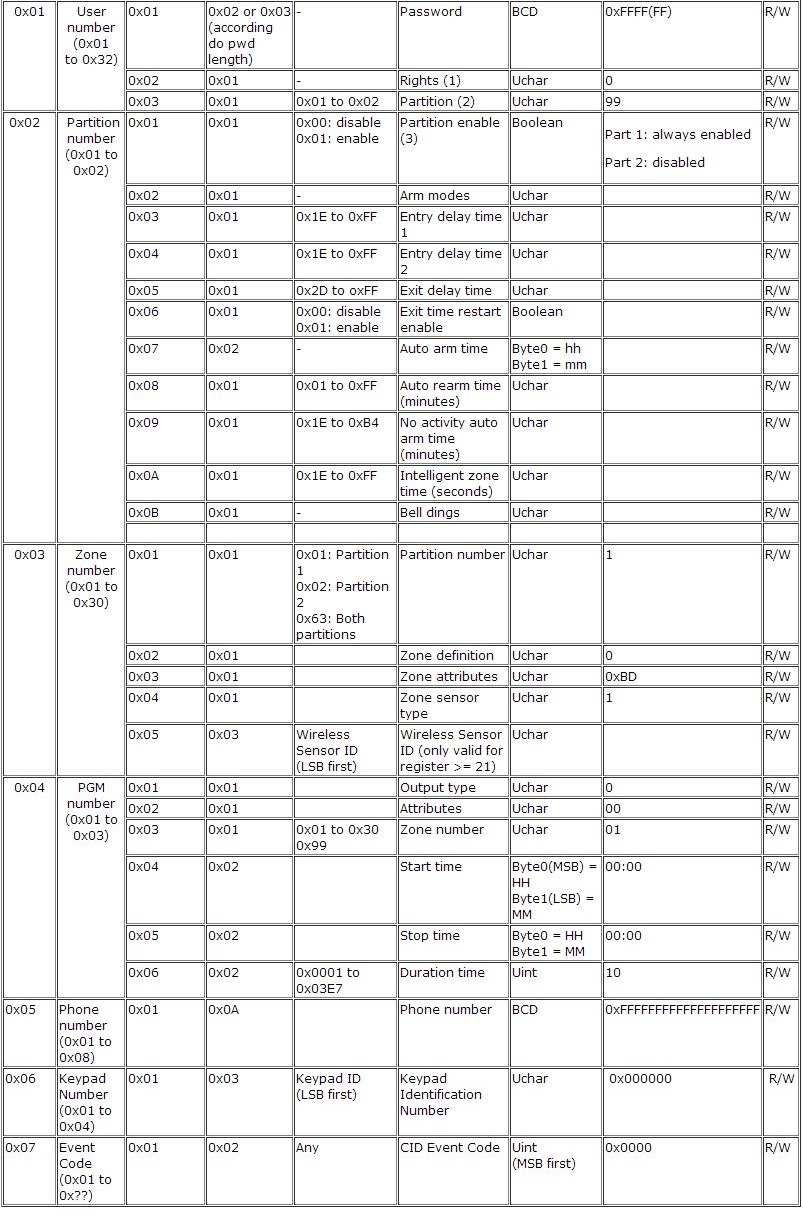
[picture p45: figure]

(1) - Los derechos de usuario del instalador, maestro del sistema,
maestro de la partición 1 y maestro de la partición 2 no se pueden modificar.
(2) - El número de partición del instalador, maestro del sistema, maestro de la partición 1 y maestro de la partición 2 no se puede modificar.
(3) - La partición 1 siempre está habilitada, por lo que no se puede deshabilitar..
(4) - Tenga en cuenta que hay 2 posibilidades: Expansión de contraseña:

La longitud de la contraseña cambia de 4 a 6 dígitos. Todos los códigos de usuario (excepto el instalador, el maestro del sistema, los maestros de partición) se borran y se restauran a sus códigos predeterminados; Contracción de contraseña:

La longitud de la contraseña cambia de 6 a 4 dígitos. Todos los códigos de usuario se truncan a 4 dígitos (2 bytes BCD). Cuando sea necesario enviar una contraseña de 3 bytes, agregue 0x00 al último byte.

FC: Valores grabados en fábrica. No puede ser cambiado por ningún usuario.

## PROTOCOLO DE COMUNICACIÓN DE LA RED HOME -EVENTOS

Los eventos se utilizan para informar cosas que están sucediendo en el dispositivo a la estación de monitoreo central (CMS).

Los eventos están formados por los siguientes campos: | Calificador de eventos (1 byte de longitud). | Código de evento (2 bytes de longitud). | Número de grupo o partición (1 byte de longitud). | Número de zona o usuario (2 bytes de longitud). | Fecha del evento (3 bytes de longitud). | Hora del evento (3 bytes de longitud).

Tenga en cuenta que, en el protocolo ContactID, no hay ninguna disposición para enviar los campos de fecha y hora. Solo se informan los campos de calificador de evento, código de evento, número de grupo o partición y número de zona o usuario.

Número de grupo o partición

Este campo se usa para indicar el número de grupo o partición con el que está relacionado el evento. Si no se aplica información específica de grupo o partición, se debe usar el valor 0.

Zona o número de usuario

Este campo se usa para indicar el número de zona o usuario con el que está relacionado el evento. Si no se aplica información específica de zona o usuario, se debe utilizar el valor 0.

Fecha del evento

Este campo que se utiliza para informar la fecha de la ocurrencia del evento. Su formato es la Fecha (ver Diccionario de datos).

Si no hay información de fecha disponible, este campo debe rellenarse con 0.

Hora del evento

Este campo se usa para informar la hora local del día en que ocurrió el evento. Su formato es Tiempo (ver Diccionario de Datos).

Si no hay información de tiempo disponible, este campo debe rellenarse con 999999.

Clasificación de eventos

El calificador de eventos es un campo de 1 byte que informa los tipos de eventos. La siguiente tabla presenta los valores posibles (esta tabla sigue el estándar SIA).

Codigos Eventos

Tabla 9 - Calificación de eventos

El código de evento es un campo de 2 bytes que se utiliza para identificar los eventos. La siguiente tabla presenta los valores posibles (esta tabla sigue el estándar SIA).

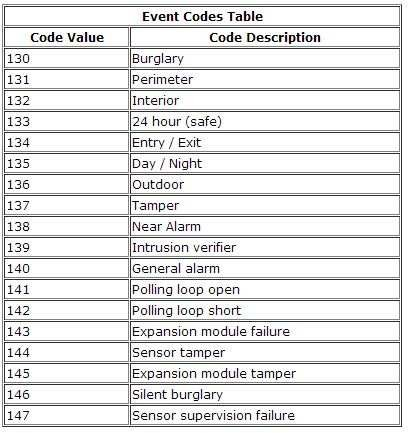
[picture p46: figure]

Tabla 10 – Códigos Eventos

## PROTOCOLO DE COMUNICACIÓN DE LA RED HOME -ESTADO DEL SISTEMA

Los mensajes de estado del sistema son utilizados por la unidad principal de alarma para notificar a los dispositivos conectados al bus acerca de cualquier cambio en el estado del sistema, como zona preparada / violación, partición armada / desarmada, entre otros. Vea a continuación la lista de subtipos de mensajes de estado del sistema y sus datos.

### 1. Formato del mensaje

El formato general para los mensajes de estado del sistema es:

SUB TIPO: El subtipo del mensaje de estado del sistema (descrito a continuación). DATA LEN: La longitud del campo DATOS.
DATA: Los datos del mensaje..

### 1. Subtipos de mensajes

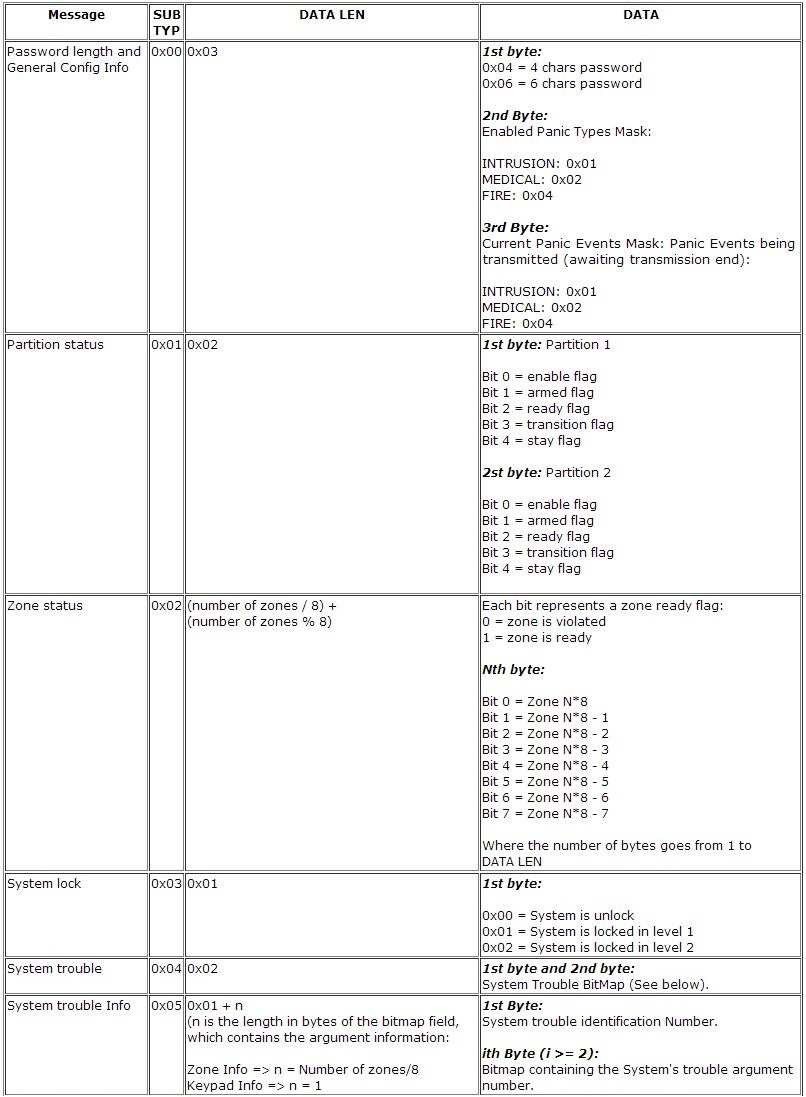
[picture p47: figure]
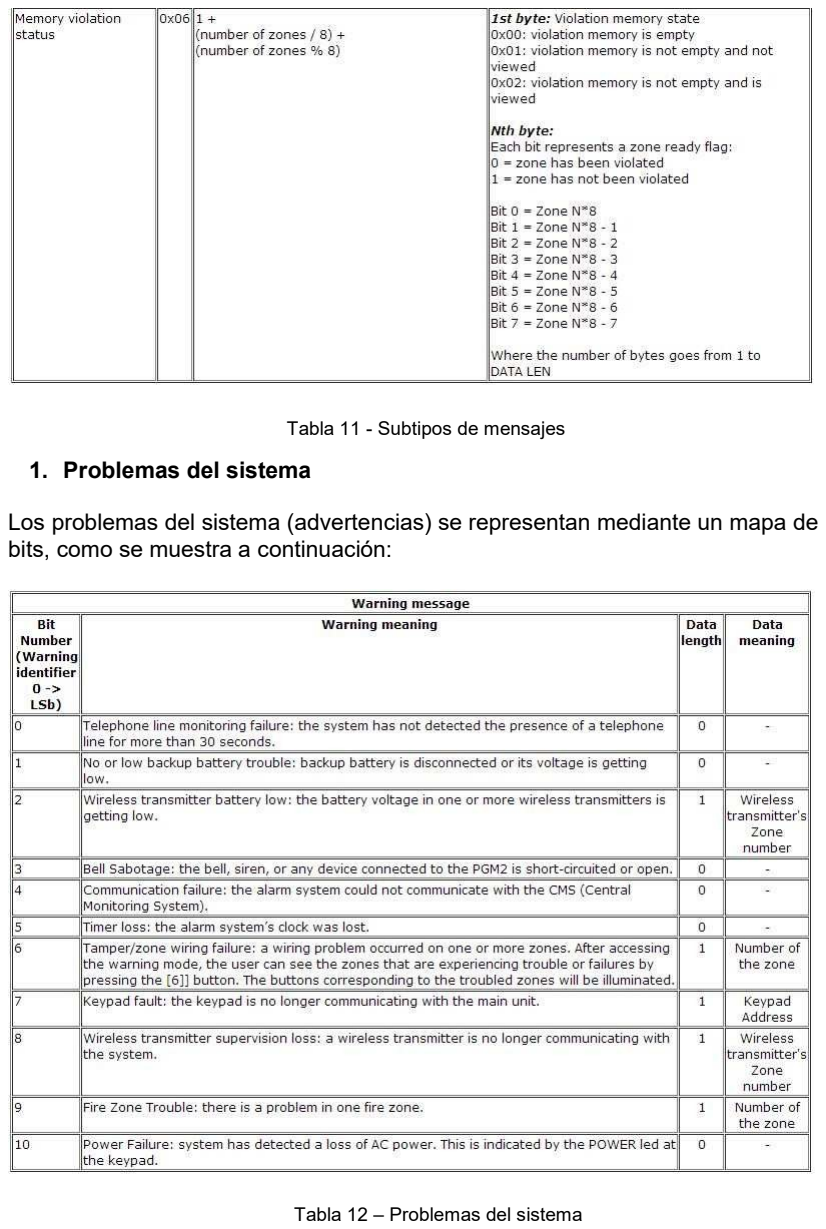
[picture p48: page 26]

Tabla 11 - Subtipos de mensajes

### 1. Problemas del sistema

Los problemas del sistema (advertencias) se representan mediante un mapa de bits, como se muestra a continuación:

Tabla 12 – Problemas del sistema
