Dy390/Documentacion/Protocolos/DSC/Clock_Data.png

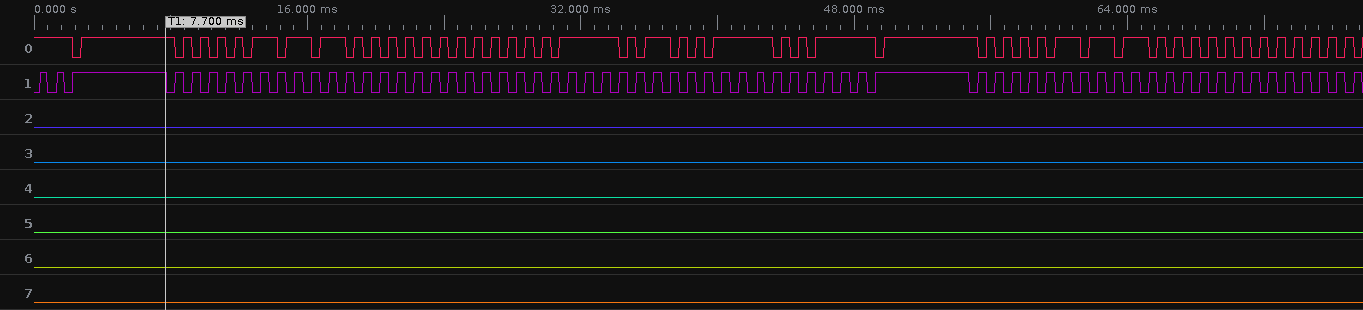
Protocolos/DSC/Clock_Data.png
