Dy390/Documentacion/Protocolos/DSC/pc1500 Keybus Layout.jpg

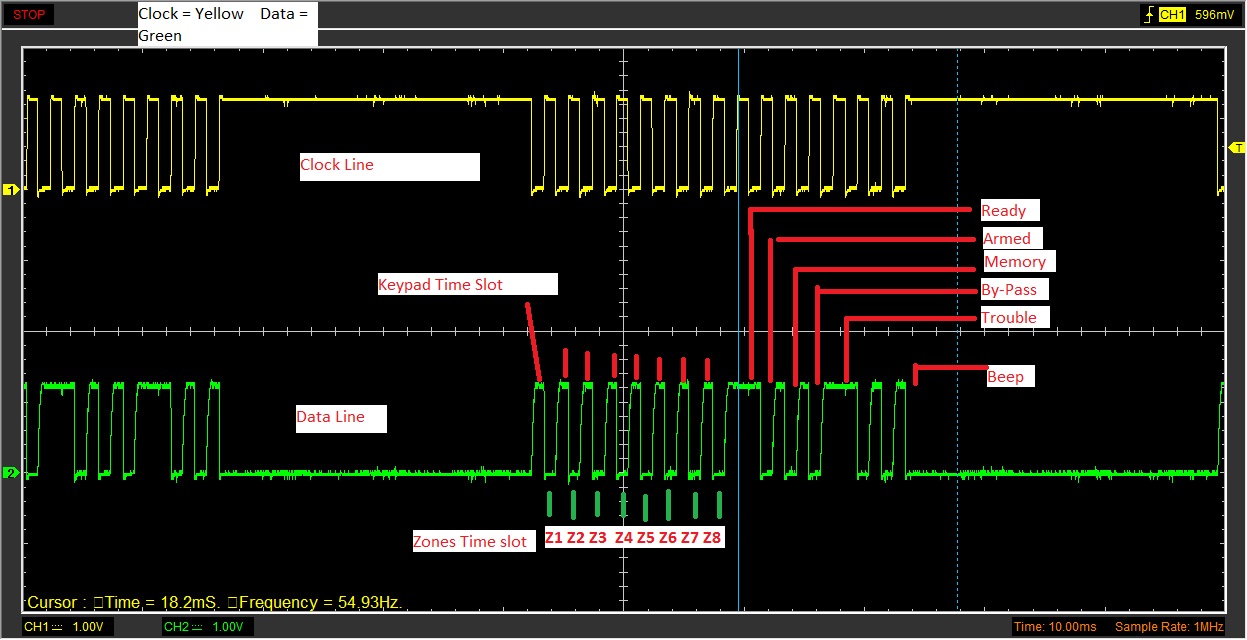
Protocolos/DSC/pc1500 Keybus Layout.jpg
