Dy390/Documentacion/Protocolos/DSC/pc1500.jpg

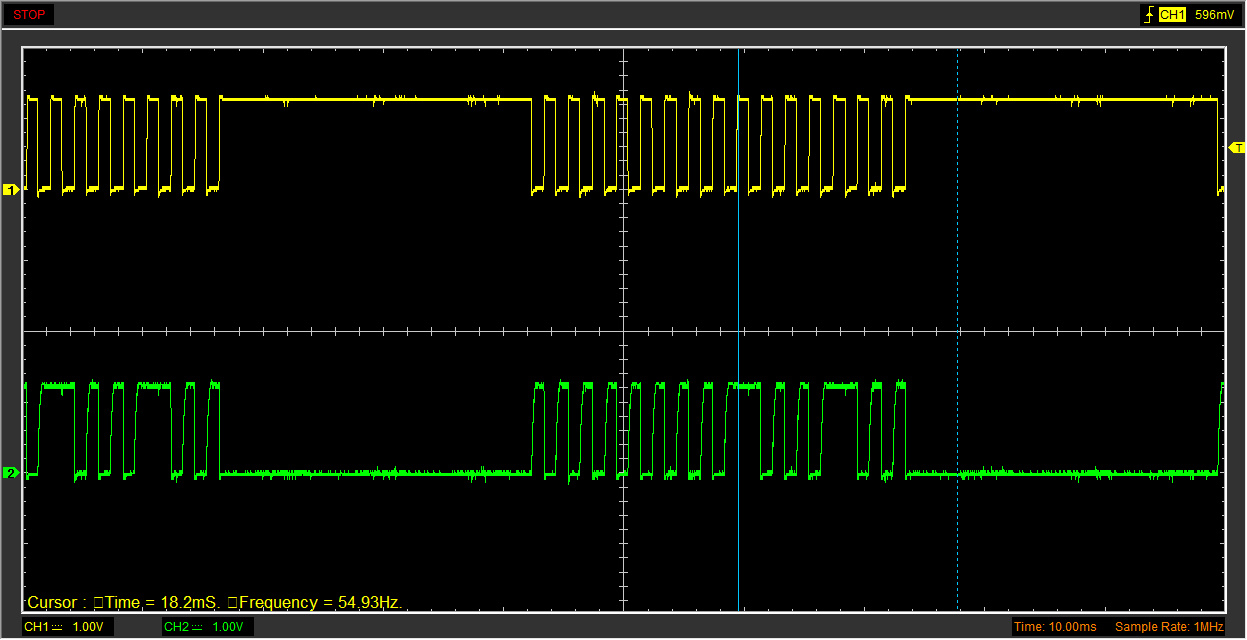
Protocolos/DSC/pc1500.jpg
