Dy390/Documentacion/Protocolos/PARADOX/Paradox1738_4bytes_Draft.png

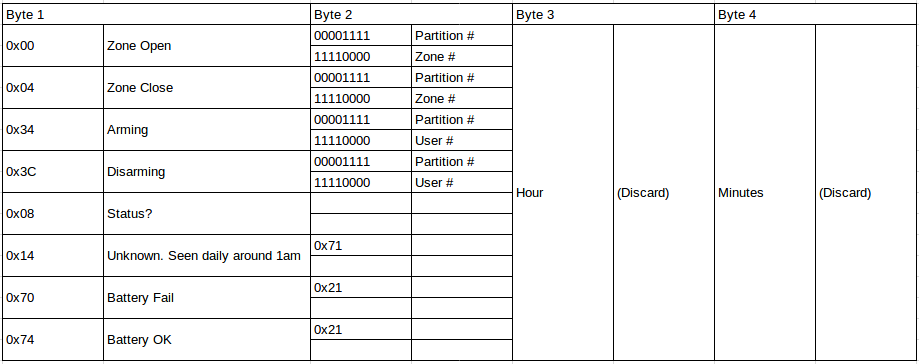
Protocolos/PARADOX/Paradox1738_4bytes_Draft.png
