Dy390/Documentacion/Protocolos/PARADOX/paradox_serial.png

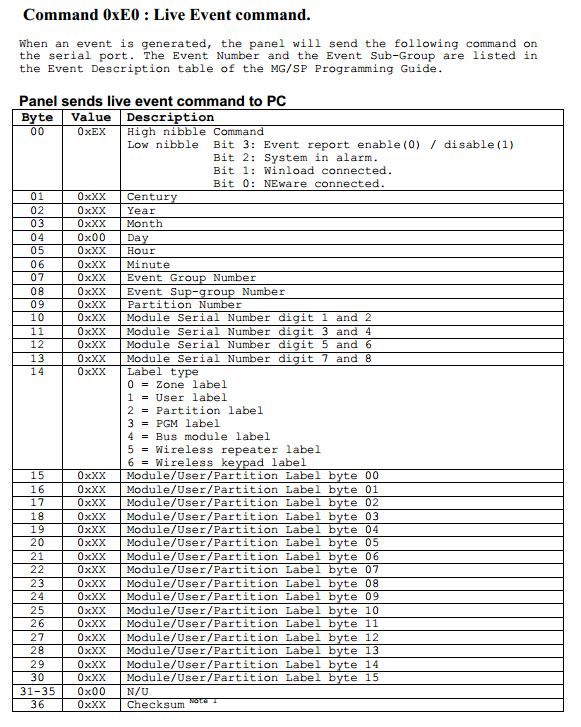
Protocolos/PARADOX/paradox_serial.png
