Dy390/Documentacion/Protocolos/Contact_ID/ARMADO DEL CID.docx

ARMADO DEL CID

[(XXXX) (18) (E/R/P) (000) (00) (000) (S)] → Paquete completo CID

Donde:

XXXX = Numero de Cuenta o subscriptor ID

18 = Tipo de Mensaje (CID)

Q = Calificador de Evento o Evento Previo 1= E (Evento) | 3= R (Restauración) | 6= P (Previo)

000 = Código de Evento

00 = Numero de Partición

000 = Numero de Zona o Usuario

S = 1 Digito Checksum (sumar todos los dígitos del mensaje + S MOD 15 = 0 )

Nota: Un "0" será valorado como un 10 para fines de suma de comprobación

Ej.: 1234 18 3131 01 015 6 -> MOD 15 = 0

58 + 6 = 60 -> MOD 15 = 0

Ejemplos paquetes con CID puro inserto

Ej. 1

INPUT 04/05/2020 16:04:58 |7905 18 3700 00 000 F|

OK 04/05/2020 16:04:58 |7905 18 3700 00 000 F|

ACK

Ej. 2

INPUT 04/05/2020 07:13:05

|$B,7903,33,04/05/2020-01:41,01,790318157001002B,15,0,0,1829,720,E2_1.04QIO,0,1,0,0,4,0,0,865733022636039,0,134,10.110.98.77,6,38075,10,$E|

OK 04/05/2020 07:13:05

|$B,7903,33,04/05/2020-01:41,01,790318157001002B,15,0,0,1829,720,E2_1.04QIO,0,1,0,0,4,0,0,865733022636039,0,134,10.110.98.77,6,38075,10,$E|

ACK 04/05/2020 07:13:05 |$B,7903,TI=04/05/2020-07:13,ACK=33,$E|

Ej. 3

INPUT 04/05/2020 07:13:06 |$D,7925,87,04/05/2020-07:12,7925181407010023,12,5,5_1.6,053050b,$C|

OK 04/05/2020 07:13:06 |$D,7925,87,04/05/2020-07:12,7925181407010023,12,5,5_1.6,053050b,$C|

ACK 04/05/2020 07:13:06 |$D,7925,TI=04/05/2020-07:13:06,ACK=87,$C|

CTRL 04/05/2020 07:13:06 |$D,7925,87|

PCOLO 04/05/2020 07:13:06 |CID|
