Dy390/Documentacion/Circuitos/uCom2_Schematics.pdf

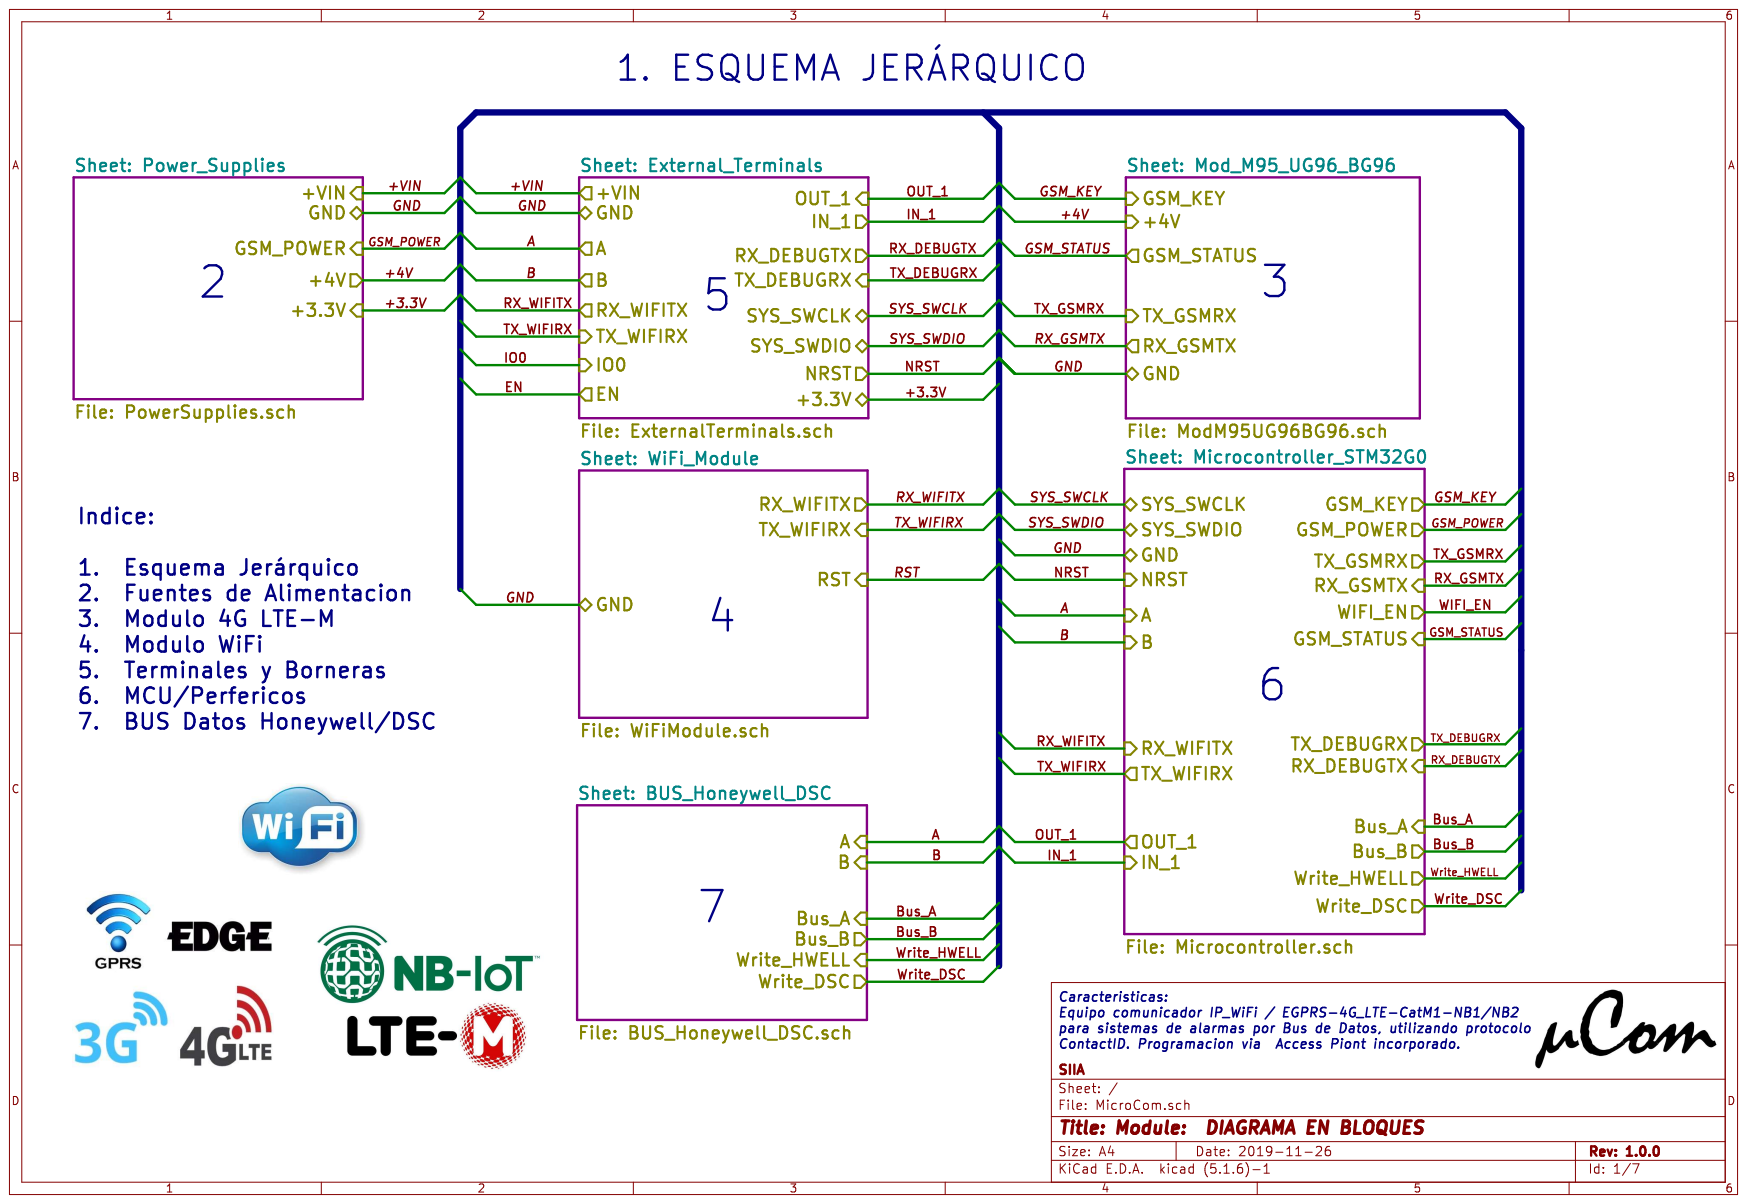
[picture p69: page 1]

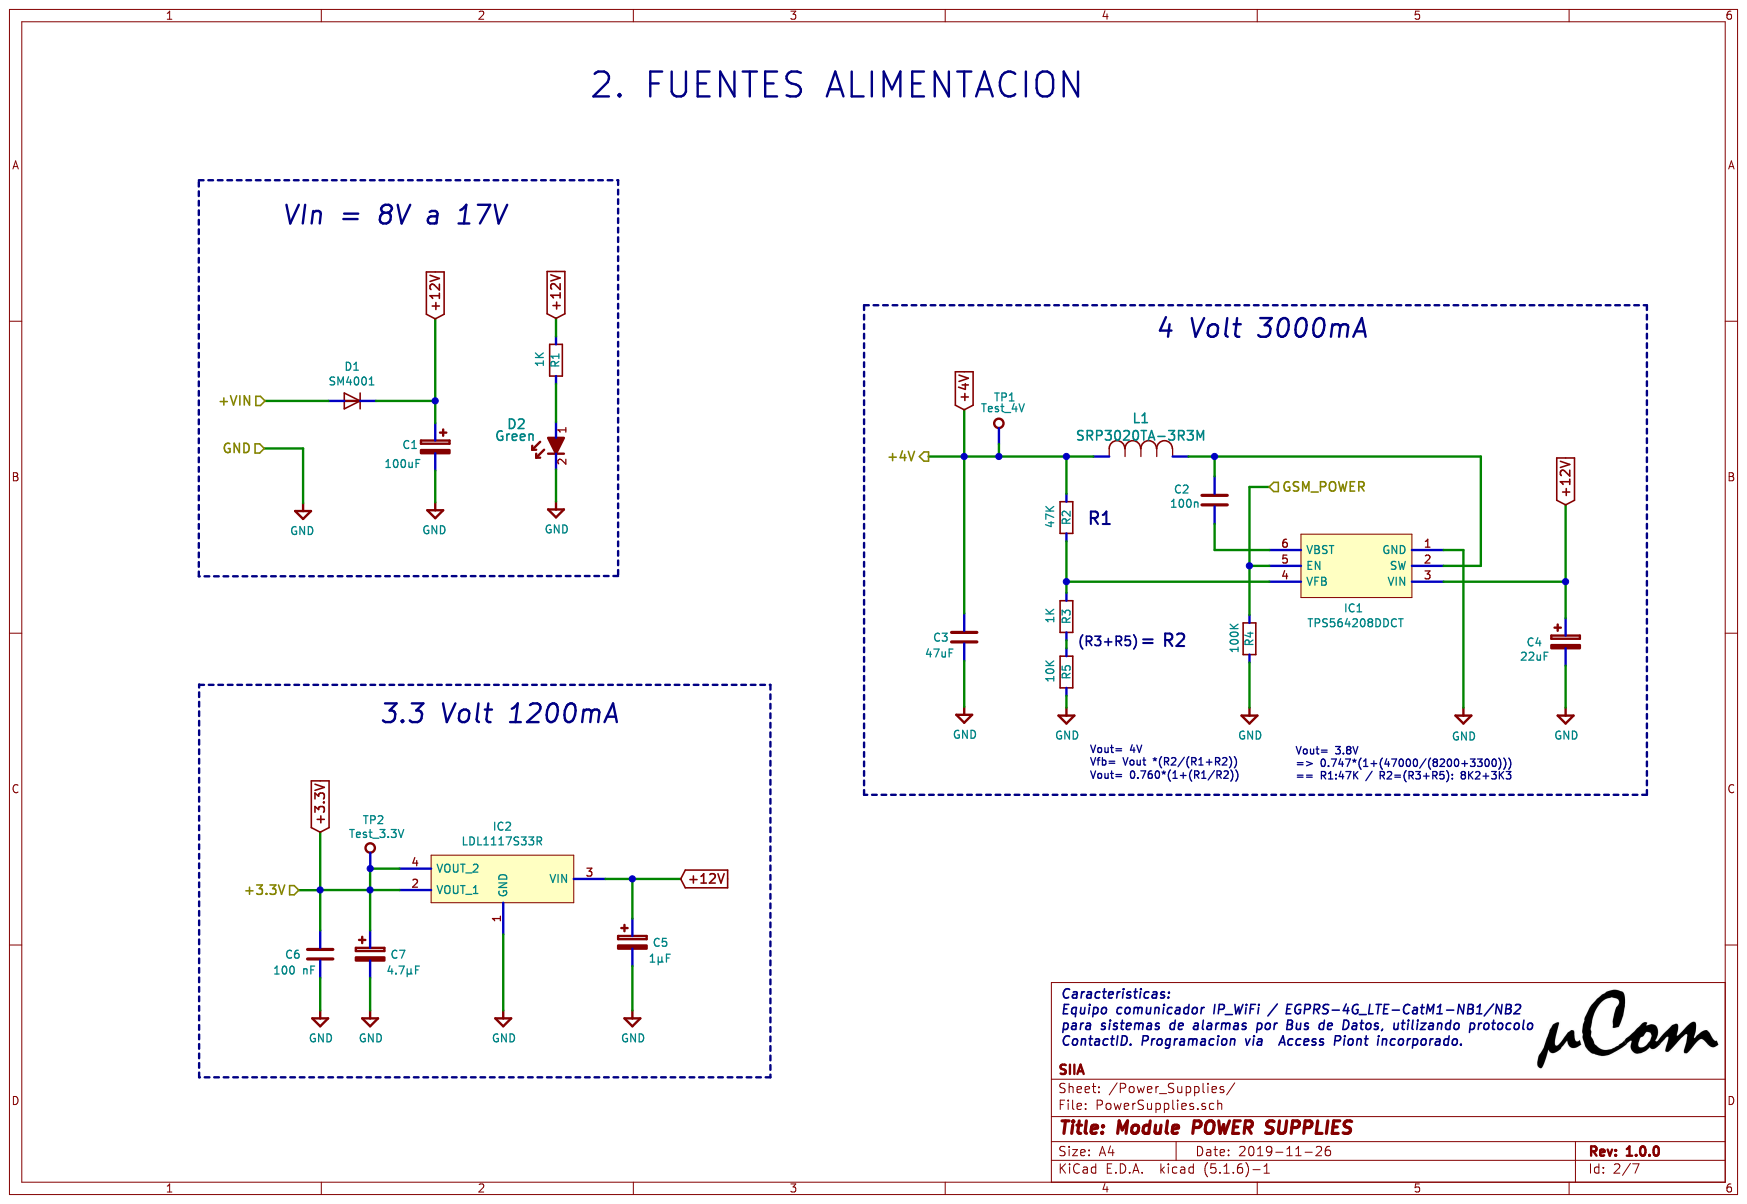
[picture p70: page 2]

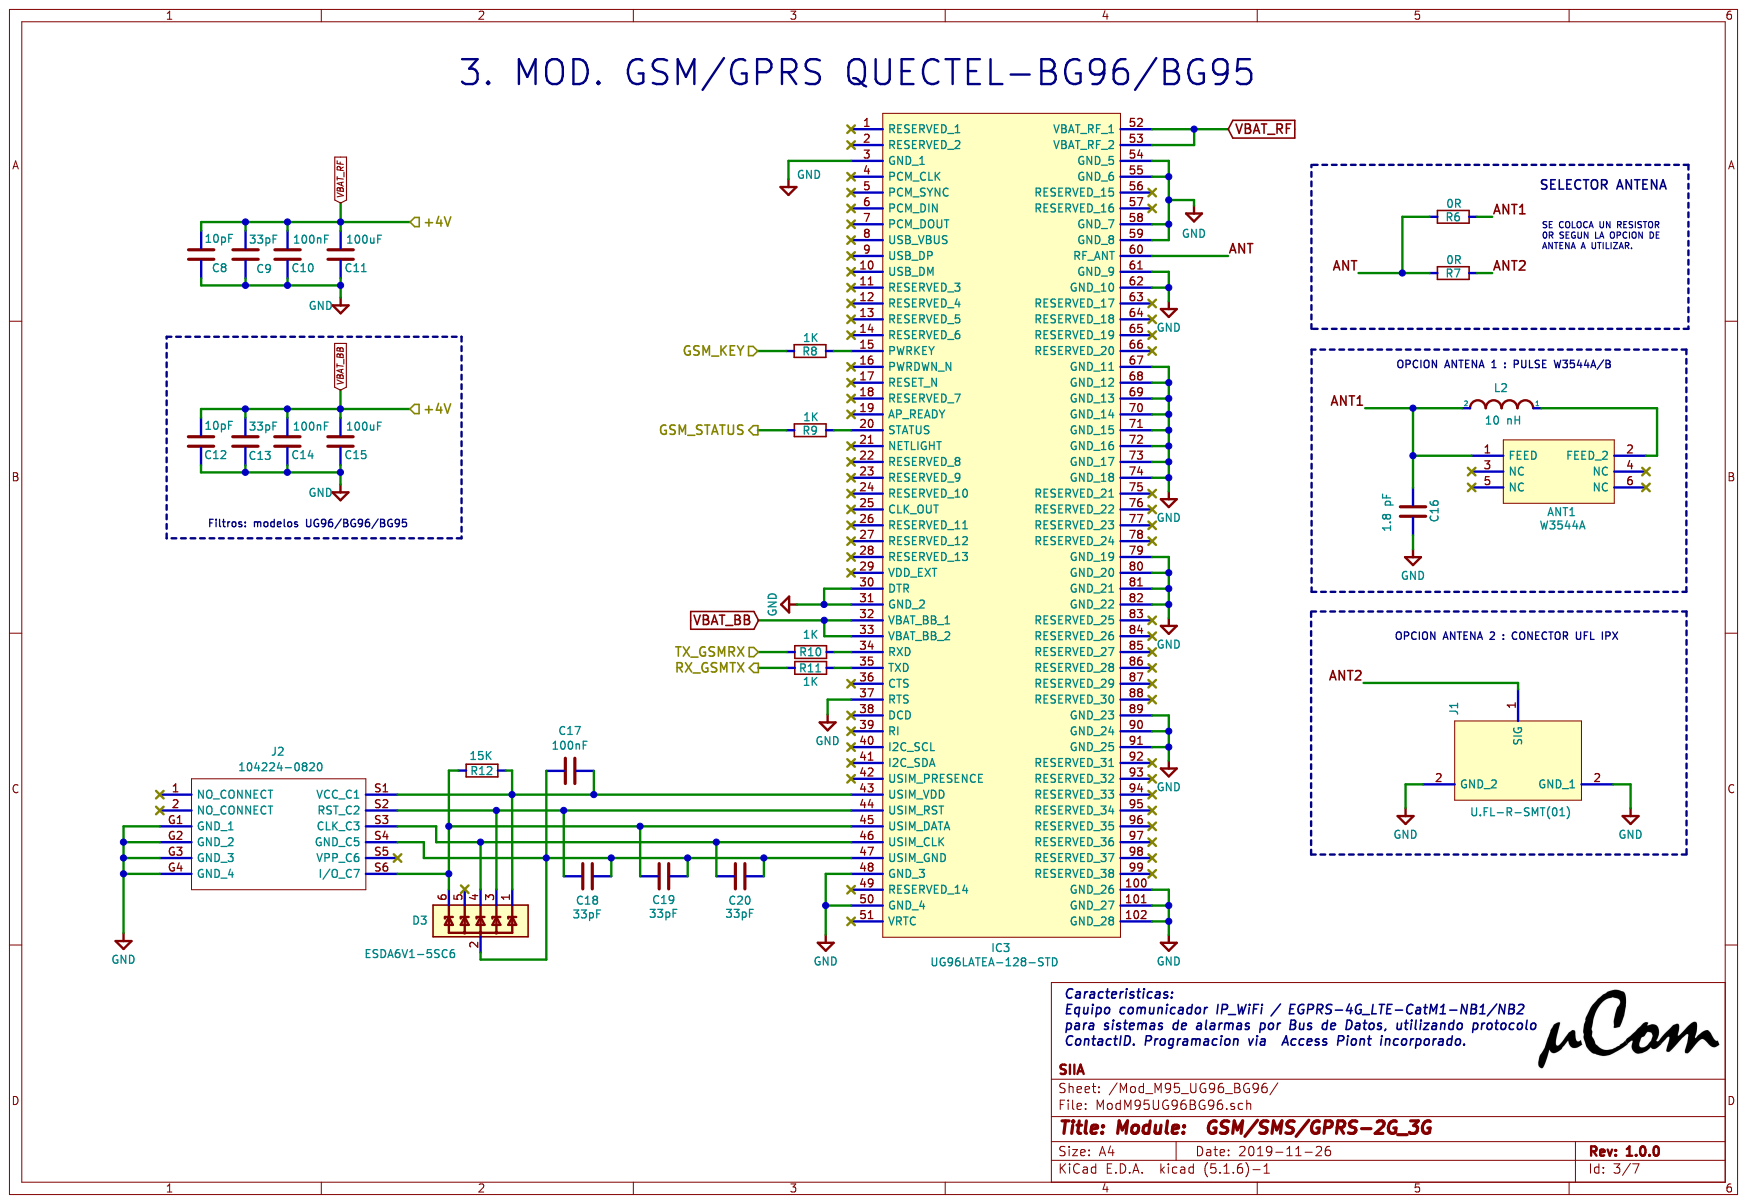
[picture p71: page 3]

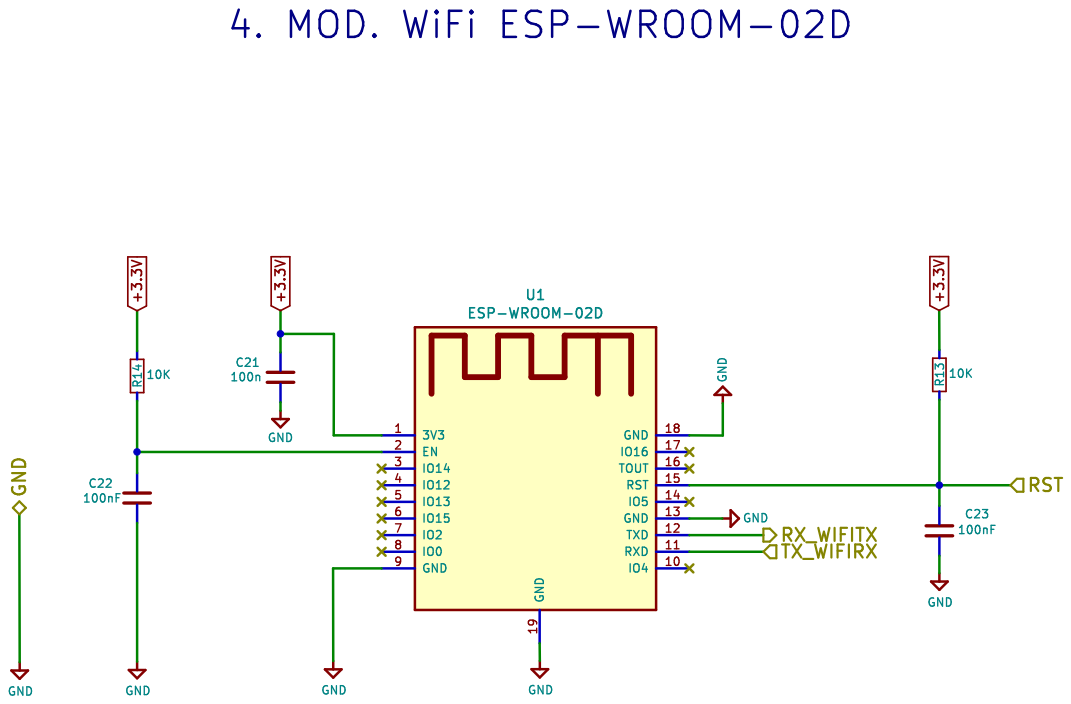
[picture p72: page 4]

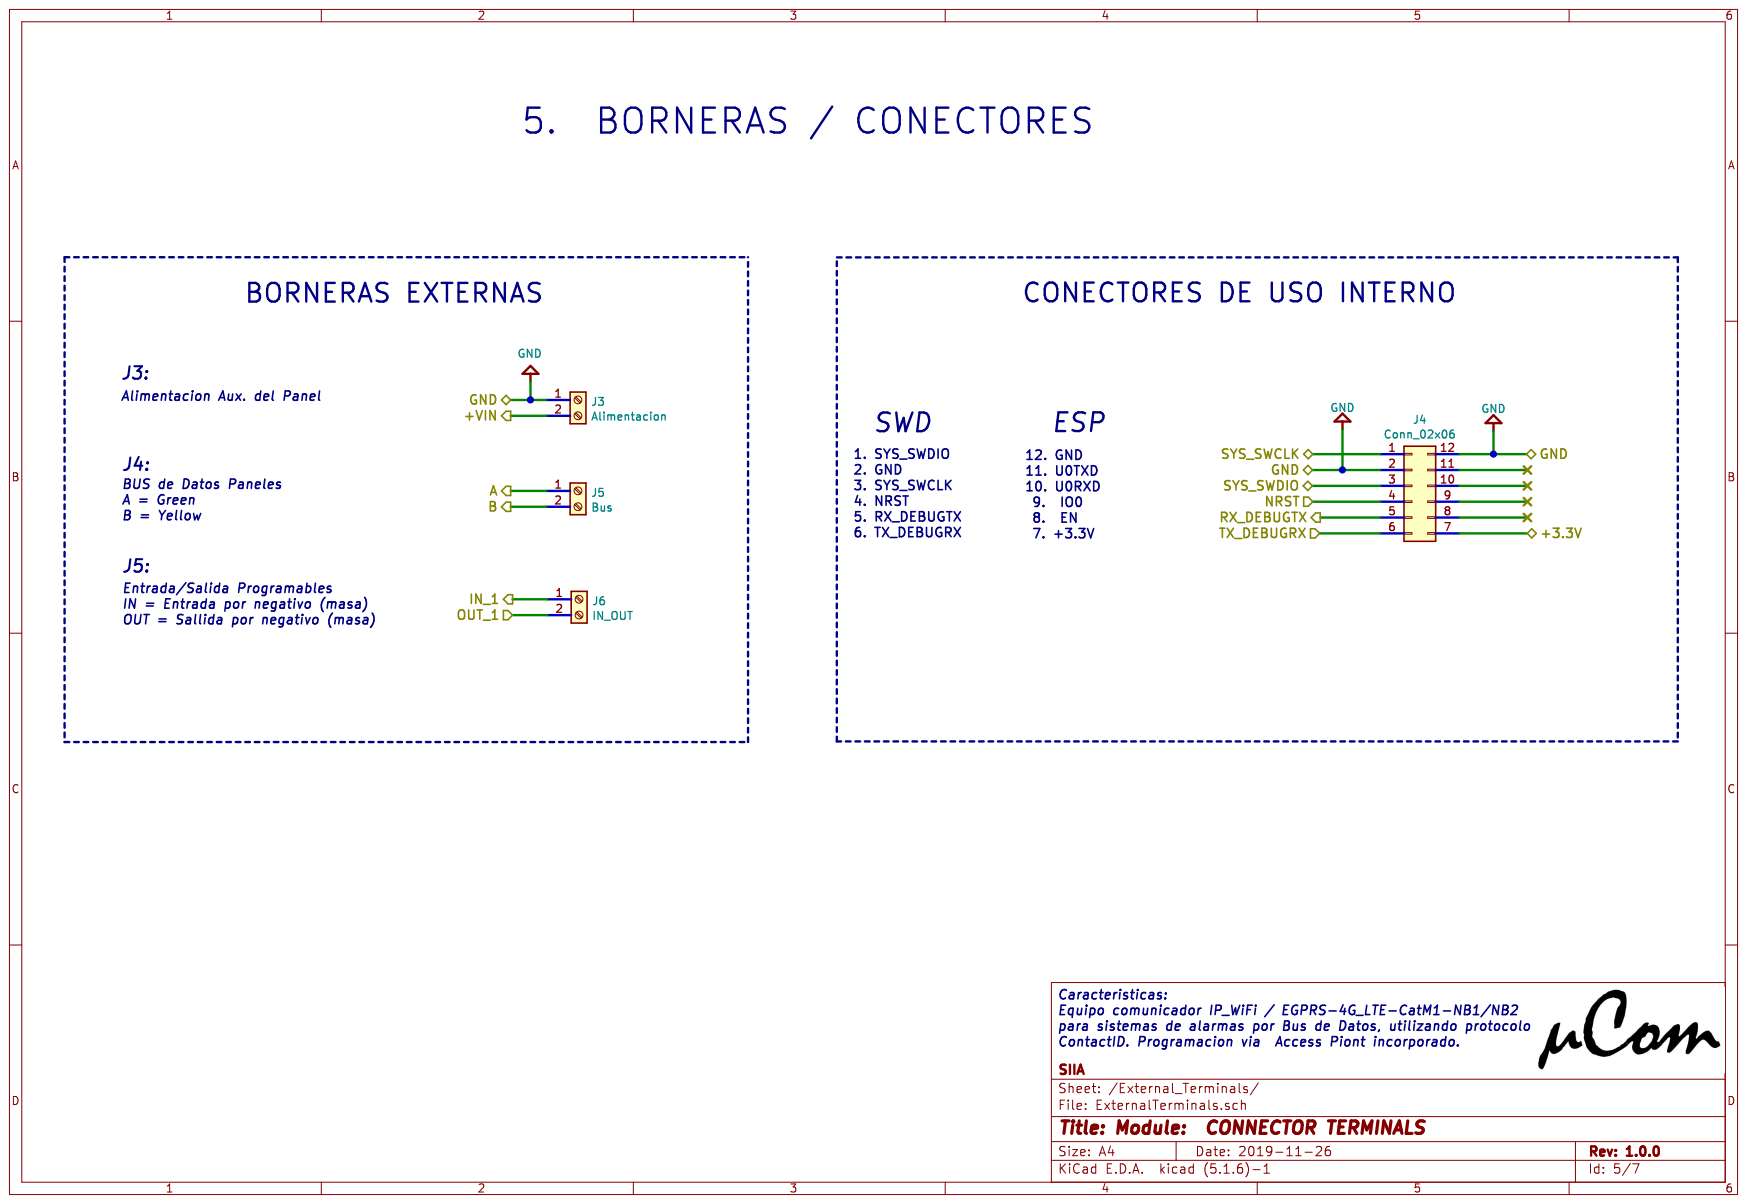
[picture p73: page 5]

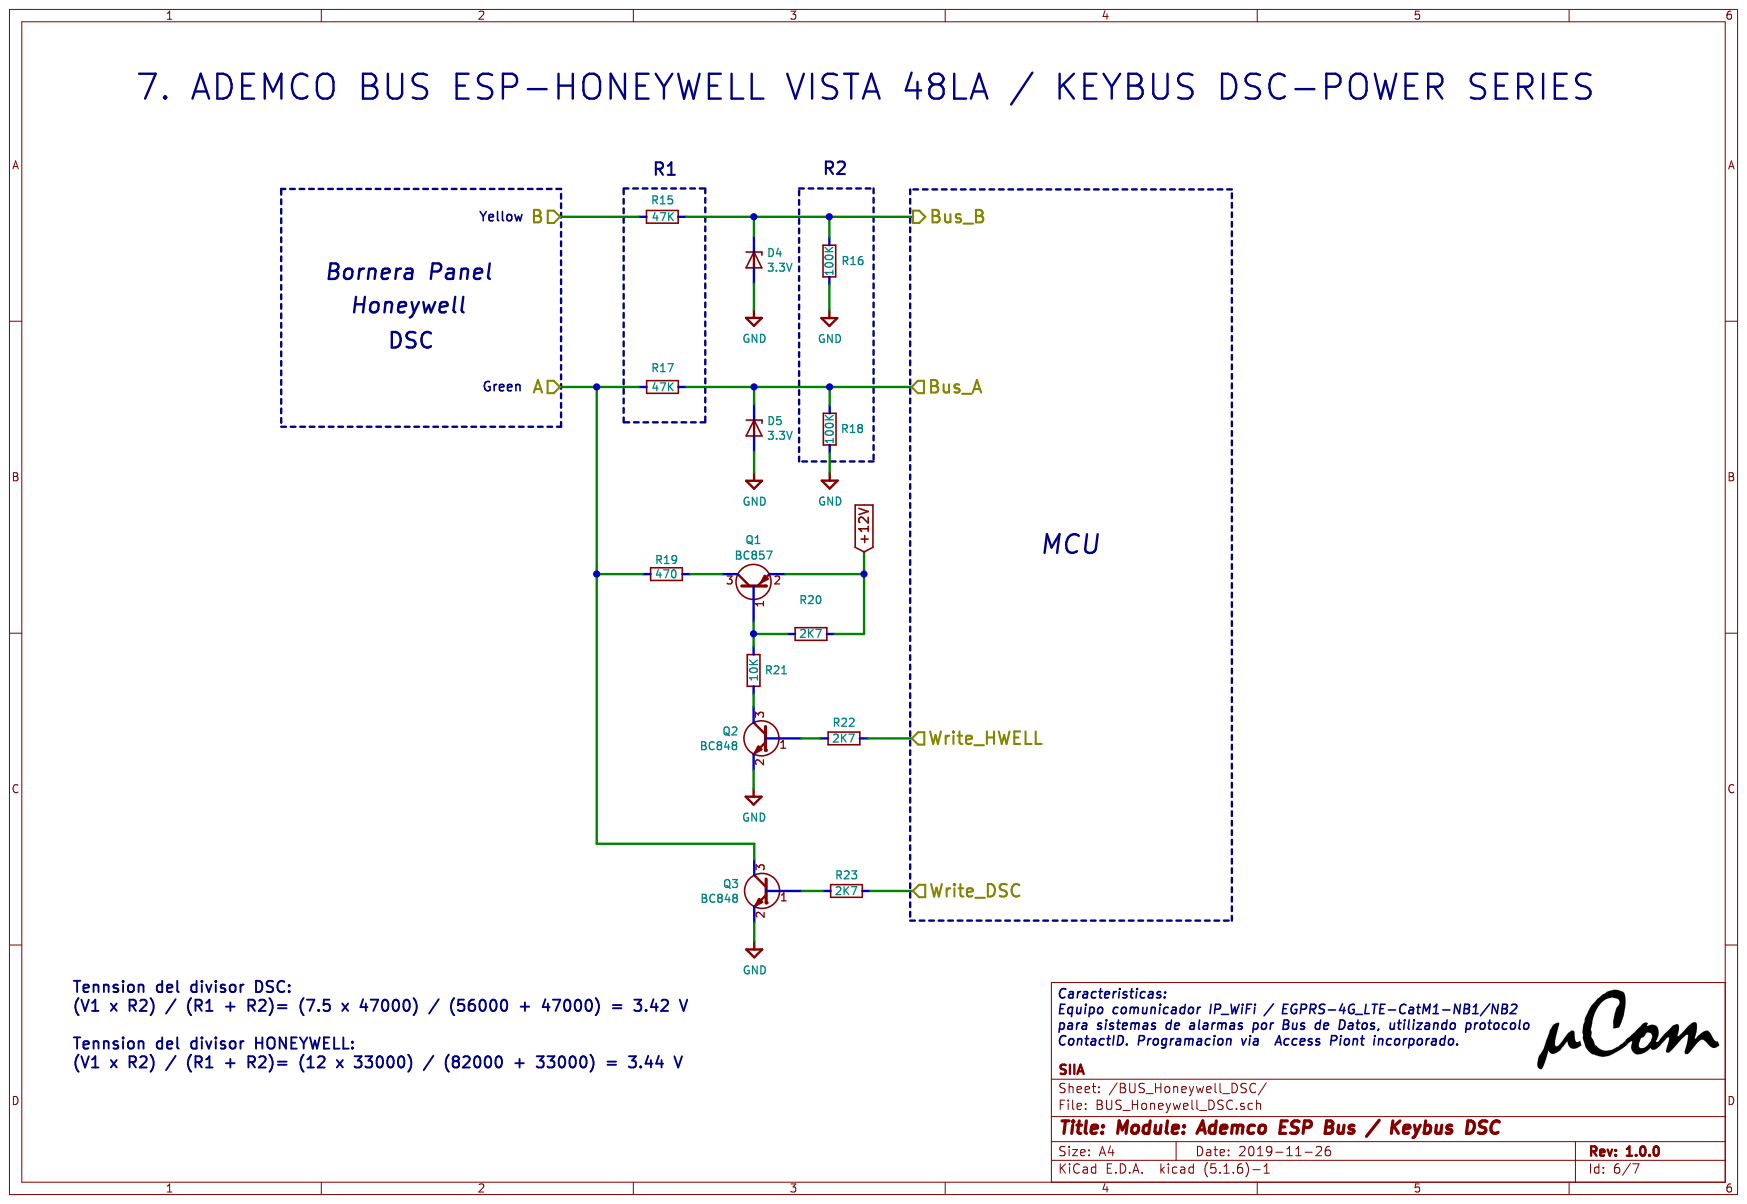
[picture p74: page 6]

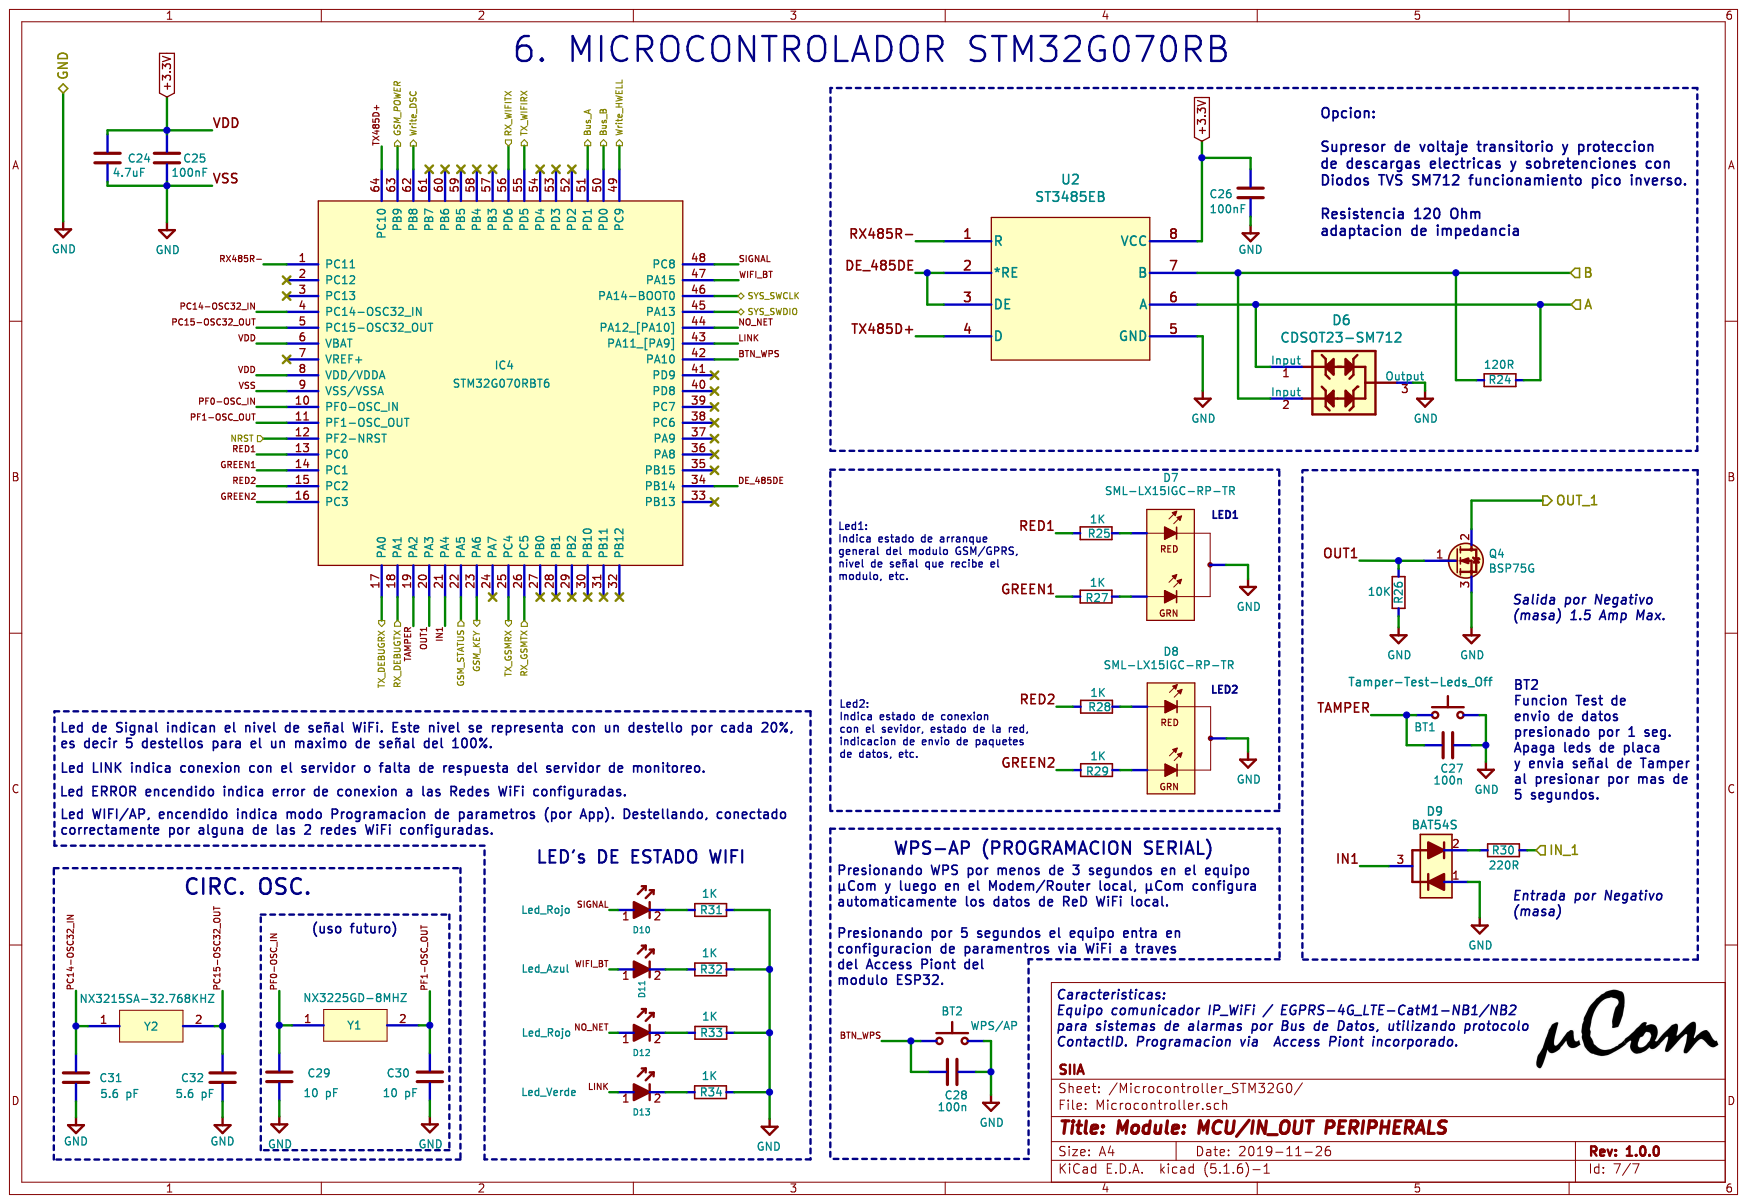
[picture p75: page 7]
