Dy390/Documentacion/Circuitos/component_layer_values.pdf

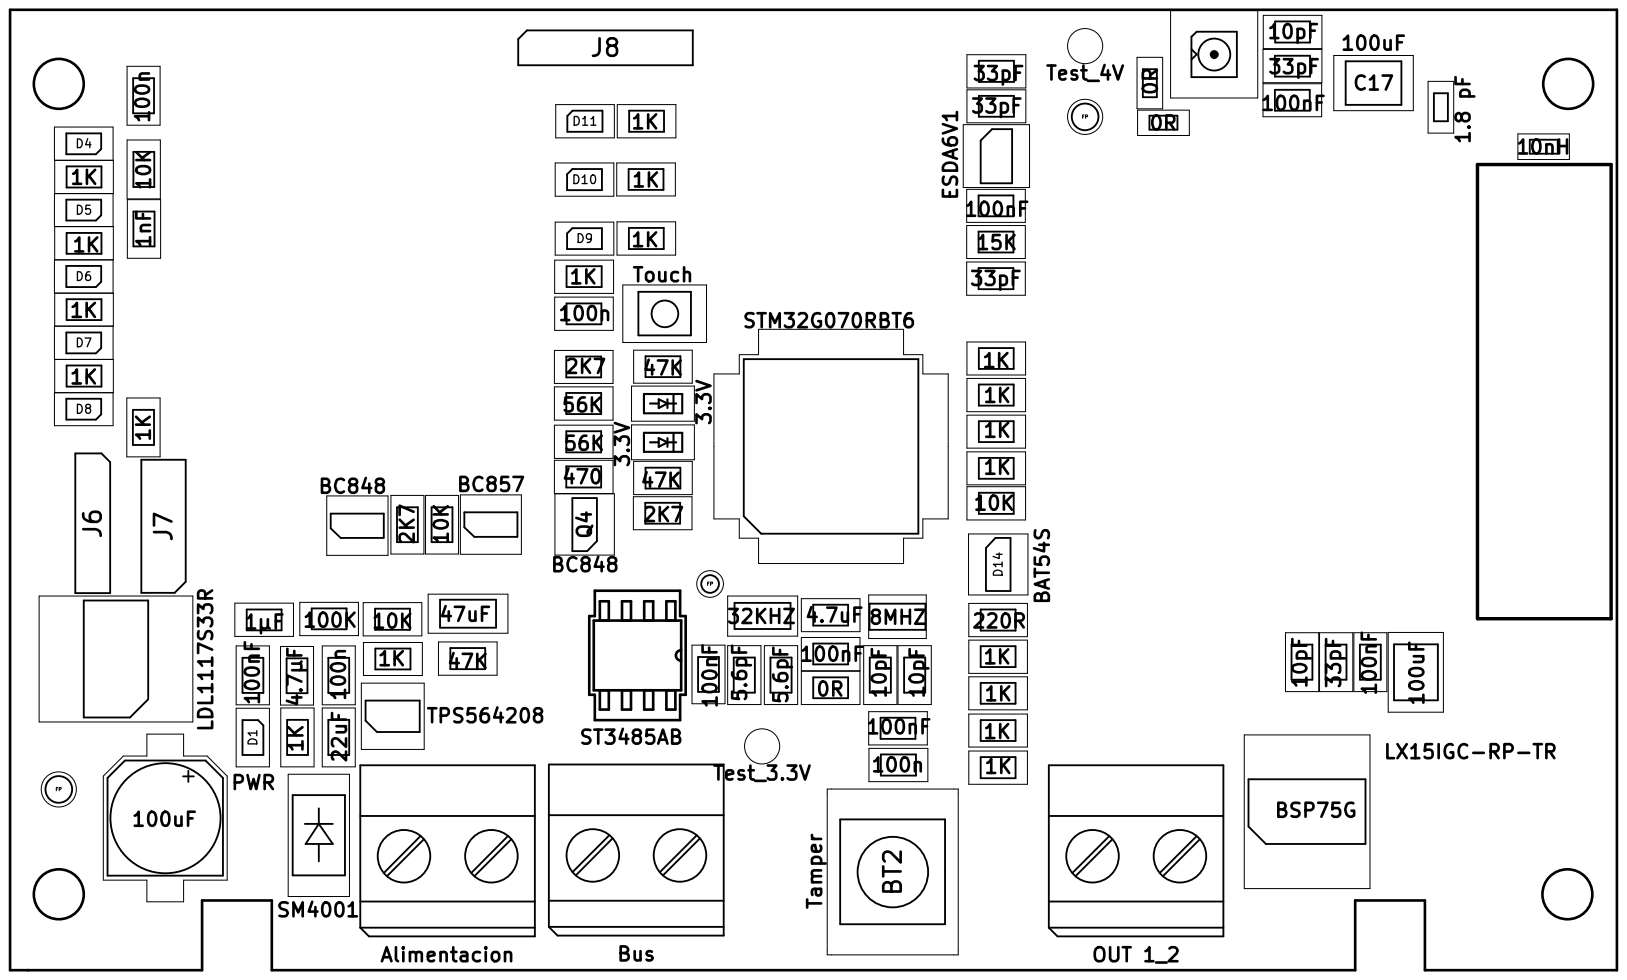
[picture p83: page 1]
