Dy390/Documentacion/Circuitos/Silks_components_V1.pdf

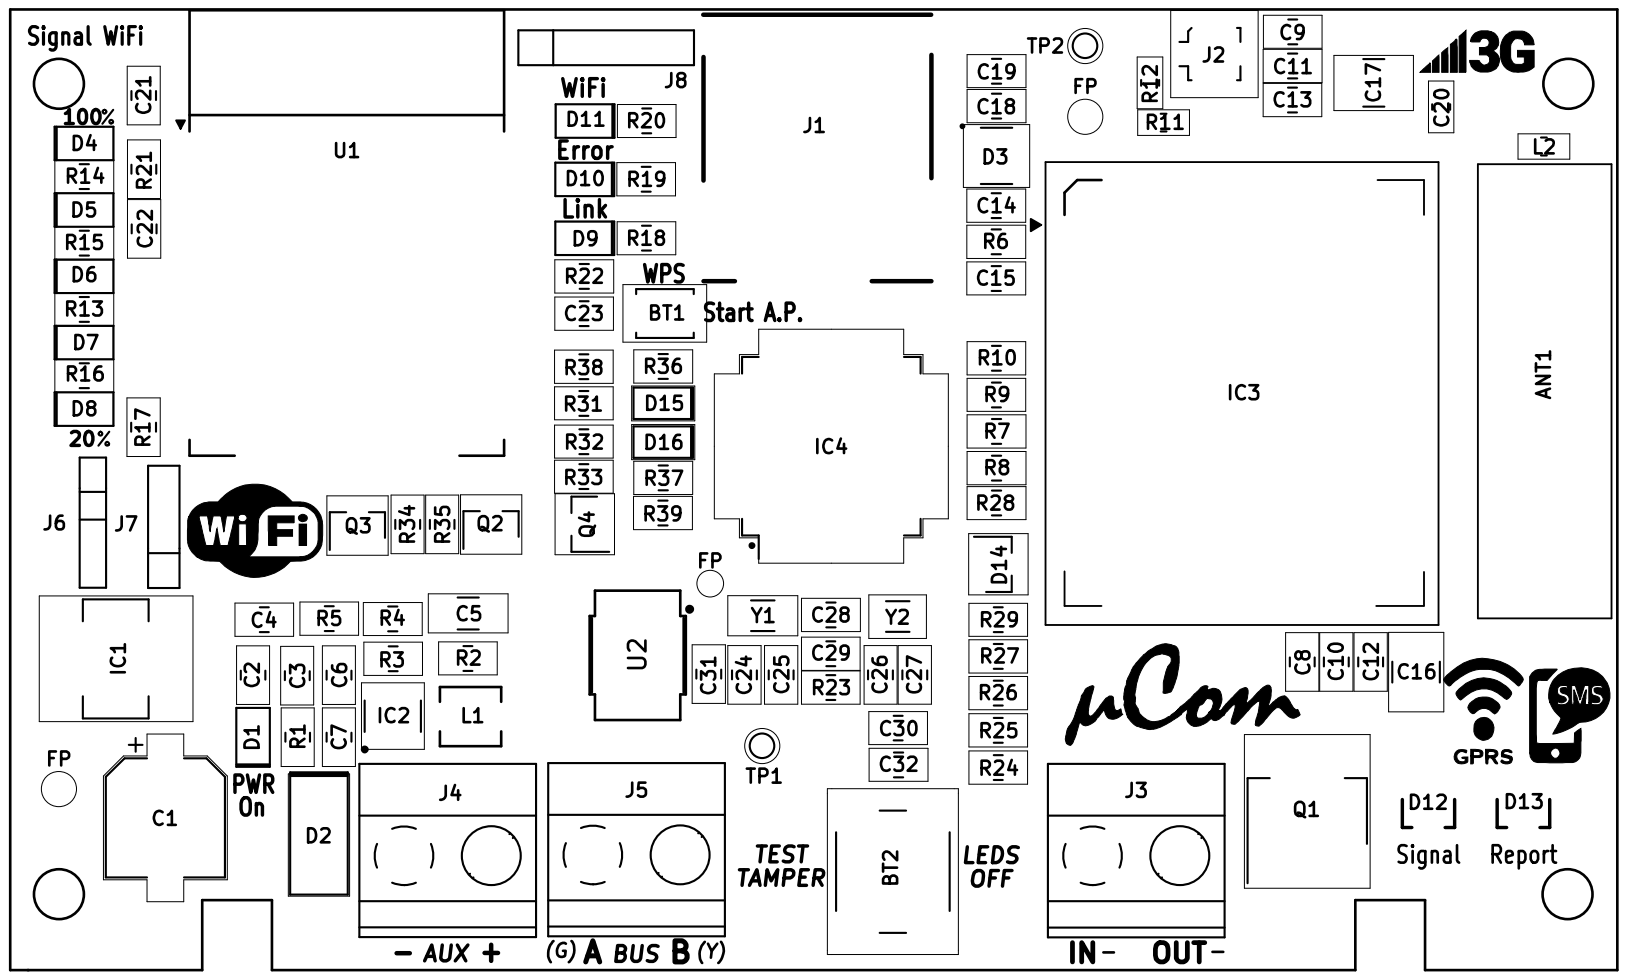
[picture p84: page 1]
