Dy390/Documentacion/Protocolos/DSC/dscKeybusInterface-master/extras/PCB Layouts/WemosD1Mini/WemosD1MiniShield.brd

## EAGLE design Protocolos/DSC/dscKeybusInterface-master/extras/PCB Layouts/WemosD1Mini/WemosD1MiniShield.brd (2020-08-02)

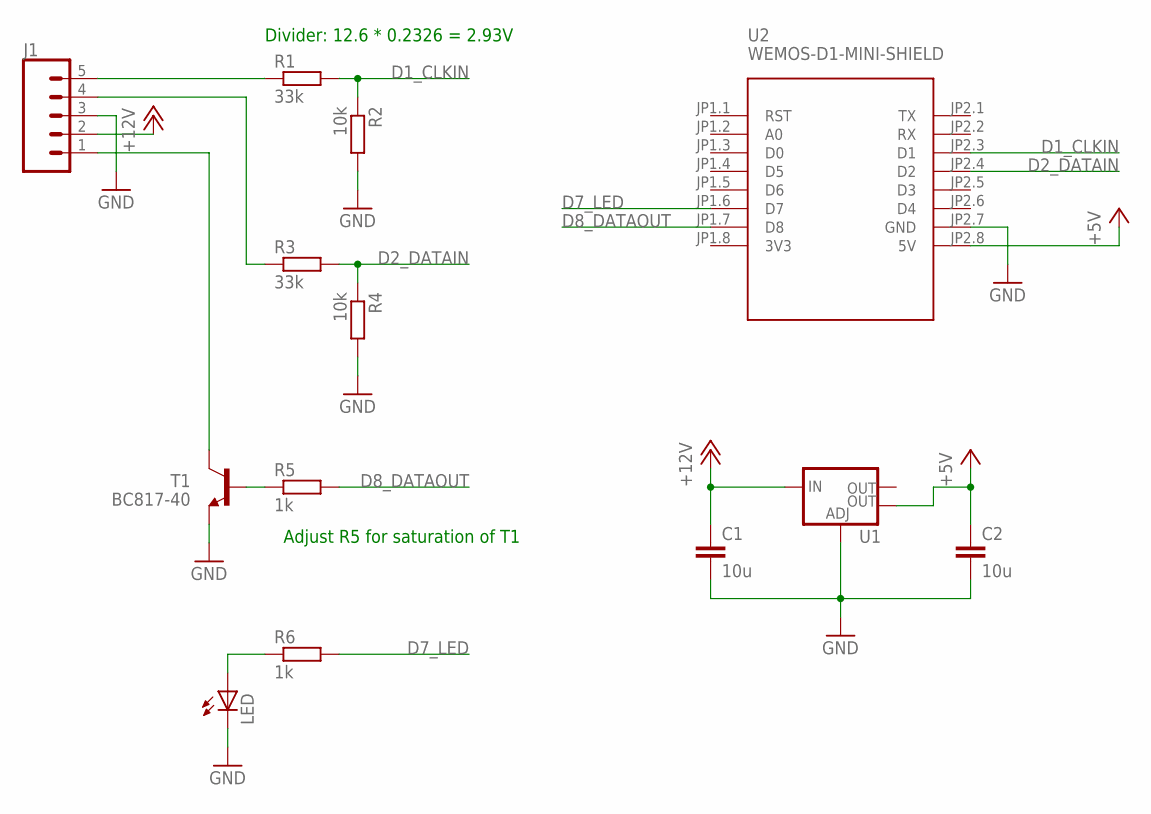
[picture p85: schematic WemosD1MiniShield.sch]

Parts:
C1, C2: 10u; C0805
J1: CONN_05LOCK; 1X05_LOCK
LED: LED1206; LED-1206
R1, R3: 33k; R0805
R2, R4: 10k; R0805
R5, R6: 1k; R0805
T1: BC817-40; SOT23-BEC
U1: V_REG_LM1117SOT223; SOT223
U2: WEMOS-D1-MINI-SHIELD

Connections:
3V3: U2.JP1.8 (3V3)
+5V: C2.1, U1.4 (OUT), U2.JP2.8 (5V)
+12V: C1.1, J1.2, U1.3 (IN)
D1_CLKIN: R1.2, R2.1, U2.JP2.3 (D1)
D2_DATAIN: R3.2, R4.1, U2.JP2.4 (D2)
D7_LED: R6.2, U2.JP1.6 (D7)
D8_DATAOUT: R5.2, U2.JP1.7 (D8)
GND: C1.2, C2.2, J1.3, LED.C, R2.2, R4.2, T1.E, U1.1 (ADJ), U2.JP2.7 (GND)
unnamed: J1.5, R1.1
unnamed: J1.4, R3.1
unnamed: J1.1, T1.C
unnamed: R5.1, T1.B
unnamed: LED.A, R6.1

Notes on the sheet:
Divider: 12.6 * 0.2326 = 2.93V
Adjust R5 for saturation of T1

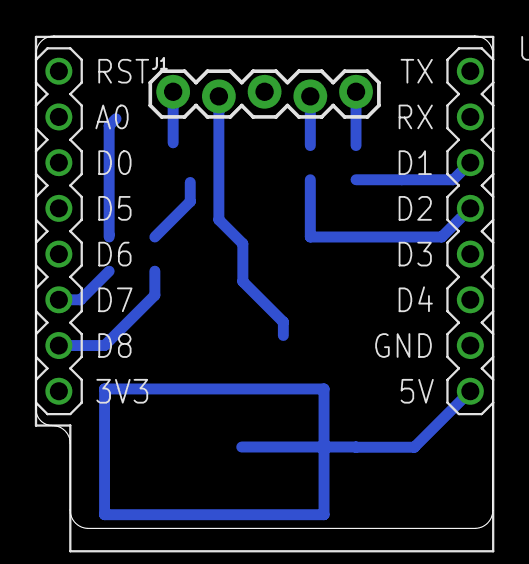
[picture p86: board WemosD1MiniShield.brd from above]

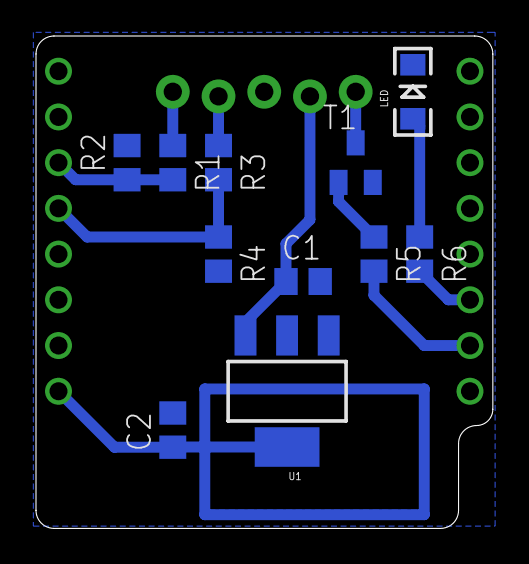
[picture p87: board WemosD1MiniShield.brd from below]

Board: 2 copper layers, 25.4 x 27.4 mm, 13 parts (11 on the bottom side), 12 nets.
