Dy390/Documentacion/Protocolos/DSC/dscKeybusInterface-master/examples/Arduino/Status/Status.ino

/*
 *  DSC Status 1.0 (Arduino)
 *
 *  Processes and prints the security system status to a serial interface, including reading from serial for the
 *  virtual keypad.  This demonstrates how to determine if the security system status has changed, what has
 *  changed, and how to take action based on those changes.
 *
 *  Wiring:
 *      DSC Aux(+) --- Arduino Vin pin
 *
 *      DSC Aux(-) --- Arduino Ground
 *
 *                                         +--- dscClockPin (Arduino Uno: 2,3)
 *      DSC Yellow --- 15k ohm resistor ---|
 *                                         +--- 10k ohm resistor --- Ground
 *
 *                                         +--- dscReadPin (Arduino Uno: 2-12)
 *      DSC Green ---- 15k ohm resistor ---|
 *                                         +--- 10k ohm resistor --- Ground
 *
 *  Virtual keypad (optional):
 *      DSC Green ---- NPN collector --\
 *                                      |-- NPN base --- 1k ohm resistor --- dscWritePin (Arduino Uno: 2-12)
 *            Ground --- NPN emitter --/
 *
 *  Virtual keypad uses an NPN transistor to pull the data line low - most small signal NPN transistors should
 *  be suitable, for example:
 *   -- 2N3904
 *   -- BC547, BC548, BC549
 *
 *  Issues and (especially) pull requests are welcome:
 *  https://github.com/taligentx/dscKeybusInterface
 *
 *  This example code is in the public domain.
 */

#include <dscKeybusInterface.h>

// Configures the Keybus interface with the specified pins - dscWritePin is optional, leaving it out disables the
// virtual keypad.
#define dscClockPin 3  // Arduino Uno hardware interrupt pin: 2,3
#define dscReadPin 4   // Arduino Uno: 2-12
#define dscWritePin 6  // Arduino Uno: 2-12
dscKeybusInterface dsc(dscClockPin, dscReadPin, dscWritePin);


void setup() {
  Serial.begin(115200);
  Serial.println();
  Serial.println();

  // Starts the Keybus interface and optionally specifies how to print data.
  // begin() sets Serial by default and can accept a different stream: begin(Serial1), etc.
  dsc.begin();

  Serial.println(F("STATUS Keybus Interface is online."));
}


void loop() {

  // Reads from serial input and writes to the Keybus as a virtual keypad
  if (Serial.available() > 0 && dsc.writeReady) {
    dsc.write(Serial.read());
  }

  if (dsc.handlePanel() && dsc.statusChanged) {  // Processes data only when a valid Keybus command has been read
    dsc.statusChanged = false;                   // Resets the status flag

    // Checks if the interface is connected to the Keybus
    if (dsc.keybusChanged) {
      dsc.keybusChanged = false;                 // Resets the Keybus data status flag
      if (dsc.keybusConnected) Serial.println(F("Keybus connected"));
      else Serial.println(F("Keybus disconnected"));
    }

    // If the Keybus data buffer is exceeded, the sketch is too busy to process all Keybus commands.  Call
    // handlePanel() more often, or increase dscBufferSize in the library: src/dscKeybusInterface.h
    if (dsc.bufferOverflow) Serial.println(F("Keybus buffer overflow"));
    dsc.bufferOverflow = false;

    // Checks status per partition
    for (byte partition = 0; partition < dscPartitions; partition++) {

      if (dsc.armedChanged[partition]) {
        dsc.armedChanged[partition] = false;  // Resets the partition armed status flag
        if (dsc.armed[partition]) {
          Serial.print(F("Partition "));
          Serial.print(partition + 1);
          Serial.print(F(" armed"));
          if (dsc.armedAway[partition]) Serial.println(F(" away"));
          if (dsc.armedStay[partition]) Serial.println(F(" stay"));
        }
        else {
          Serial.print(F("Partition "));
          Serial.print(partition + 1);
          Serial.println(F(" disarmed"));
        }
      }

      if (dsc.alarmChanged[partition]) {
        dsc.alarmChanged[partition] = false;  // Resets the partition alarm status flag
        if (dsc.alarm[partition]) {
          Serial.print(F("Partition "));
          Serial.print(partition + 1);
          Serial.println(F(" in alarm"));
        }
      }

      if (dsc.exitDelayChanged[partition]) {
        dsc.exitDelayChanged[partition] = false;  // Resets the exit delay status flag
        if (dsc.exitDelay[partition]) {
          Serial.print(F("Partition "));
          Serial.print(partition + 1);
          Serial.println(F(" exit delay in progress"));
        }
      }

      if (dsc.entryDelayChanged[partition]) {
        dsc.entryDelayChanged[partition] = false;  // Resets the exit delay status flag
        if (dsc.entryDelay[partition]) {
          Serial.print(F("Partition "));
          Serial.print(partition + 1);
          Serial.println(F(" entry delay in progress"));
        }
      }

      if (dsc.fireChanged[partition]) {
        dsc.fireChanged[partition] = false;  // Resets the fire status flag
        if (dsc.fire[partition]) {
          Serial.print(F("Partition "));
          Serial.print(partition + 1);
          Serial.println(F(" fire alarm on"));
        }
        else {
          Serial.print(F("Partition "));
          Serial.print(partition + 1);
          Serial.println(F(" fire alarm restored"));
        }
      }
    }

    // Zone status is stored in the openZones[] and openZonesChanged[] arrays using 1 bit per zone, up to 64 zones
    //   openZones[0] and openZonesChanged[0]: Bit 0 = Zone 1 ... Bit 7 = Zone 8
    //   openZones[1] and openZonesChanged[1]: Bit 0 = Zone 9 ... Bit 7 = Zone 16
    //   ...
    //   openZones[7] and openZonesChanged[7]: Bit 0 = Zone 57 ... Bit 7 = Zone 64
    if (dsc.openZonesStatusChanged) {
      dsc.openZonesStatusChanged = false;                           // Resets the open zones status flag
      for (byte zoneGroup = 0; zoneGroup < dscZones; zoneGroup++) {
        for (byte zoneBit = 0; zoneBit < 8; zoneBit++) {
          if (bitRead(dsc.openZonesChanged[zoneGroup], zoneBit)) {  // Checks an individual open zone status flag
            bitWrite(dsc.openZonesChanged[zoneGroup], zoneBit, 0);  // Resets the individual open zone status flag
            if (bitRead(dsc.openZones[zoneGroup], zoneBit)) {       // Zone open
              Serial.print(F("Zone open: "));
              Serial.println(zoneBit + 1 + (zoneGroup * 8));        // Determines the zone number
            }
            else {                                                  // Zone closed
              Serial.print(F("Zone restored: "));
              Serial.println(zoneBit + 1 + (zoneGroup * 8));        // Determines the zone number
            }
          }
        }
      }
    }

    // Zone alarm status is stored in the alarmZones[] and alarmZonesChanged[] arrays using 1 bit per zone, up to 64 zones
    //   alarmZones[0] and alarmZonesChanged[0]: Bit 0 = Zone 1 ... Bit 7 = Zone 8
    //   alarmZones[1] and alarmZonesChanged[1]: Bit 0 = Zone 9 ... Bit 7 = Zone 16
    //   ...
    //   alarmZones[7] and alarmZonesChanged[7]: Bit 0 = Zone 57 ... Bit 7 = Zone 64
    if (dsc.alarmZonesStatusChanged) {
      dsc.alarmZonesStatusChanged = false;                           // Resets the alarm zones status flag
      for (byte zoneGroup = 0; zoneGroup < dscZones; zoneGroup++) {
        for (byte zoneBit = 0; zoneBit < 8; zoneBit++) {
          if (bitRead(dsc.alarmZonesChanged[zoneGroup], zoneBit)) {  // Checks an individual alarm zone status flag
            bitWrite(dsc.alarmZonesChanged[zoneGroup], zoneBit, 0);  // Resets the individual alarm zone status flag
            if (bitRead(dsc.alarmZones[zoneGroup], zoneBit)) {       // Zone alarm
              Serial.print(F("Zone alarm: "));
              Serial.println(zoneBit + 1 + (zoneGroup * 8));         // Determines the zone number
            }
            else {
              Serial.print(F("Zone alarm restored: "));
              Serial.println(zoneBit + 1 + (zoneGroup * 8));         // Determines the zone number
            }
          }
        }
      }
    }

    if (dsc.troubleChanged) {
      dsc.troubleChanged = false;  // Resets the trouble status flag
      if (dsc.trouble) Serial.println(F("Trouble status on"));
      else Serial.println(F("Trouble status restored"));
    }

    if (dsc.powerChanged) {
      dsc.powerChanged = false;  // Resets the power trouble status flag
      if (dsc.powerTrouble) Serial.println(F("Panel AC power trouble"));
      else Serial.println(F("Panel AC power restored"));
    }

    if (dsc.batteryChanged) {
      dsc.batteryChanged = false;  // Resets the battery trouble status flag
      if (dsc.batteryTrouble) Serial.println(F("Panel battery trouble"));
      else Serial.println(F("Panel battery restored"));
    }

    if (dsc.keypadFireAlarm) {
      dsc.keypadFireAlarm = false;  // Resets the keypad fire alarm status flag
      Serial.println(F("Keypad fire alarm"));
    }

    if (dsc.keypadAuxAlarm) {
      dsc.keypadAuxAlarm = false;  // Resets the keypad auxiliary alarm status flag
      Serial.println(F("Keypad aux alarm"));
    }

    if (dsc.keypadPanicAlarm) {
      dsc.keypadPanicAlarm = false;  // Resets the keypad panic alarm status flag
      Serial.println(F("Keypad panic alarm"));
    }
  }
}
