Dy390/Documentacion/(commit log)

2020-06-13 agrego carpeta de terminologia de programacion y comandos de usuarios residencial por SMS
2020-06-13 cambio nombre de archivo
2020-06-15 subo esquematico de uCom2
2020-06-15 modifico esquematico de uCom2
2020-06-17 agrego archivos silk/Layer de componentes
2020-06-17 modificacion de archivos
2020-06-17 modificacion de archivo
2020-06-22 Modificaciones en Manual General y Programacion_SMS, agregado de planilla led_parametros_fallas
    [LEDs_Parametros_Fallas.xlsx]
2020-06-24 Modificaciones en Manual General y agrego ET de conectores de programacion en PCB
    [LEDs_Parametros_Fallas.xlsx]
2020-06-29 Elimino version equivocada de iBom.html
2020-06-29 Subo version correcta de iBom.html
2020-06-30 Subo Nota del cambio de tecnologia en las comunicaciones
2020-06-30 modifique el Readme
2020-06-30 se agrega la carpeta herramientas
2020-07-01 Agrego PDF de la Nota
2020-07-01 Correccion de la Nota
2020-07-01 untracked .doc .xlsx files
    [LEDs_Parametros_Fallas.xlsx]
2020-07-12 modificaciones para iBom
2020-08-02 subo carpeta Protocolos
    [WemosD1MiniShield.brd, WemosD1MiniShield.sch]
